Aimmecat/IEECS-Design/README.md

# IEECS-Design

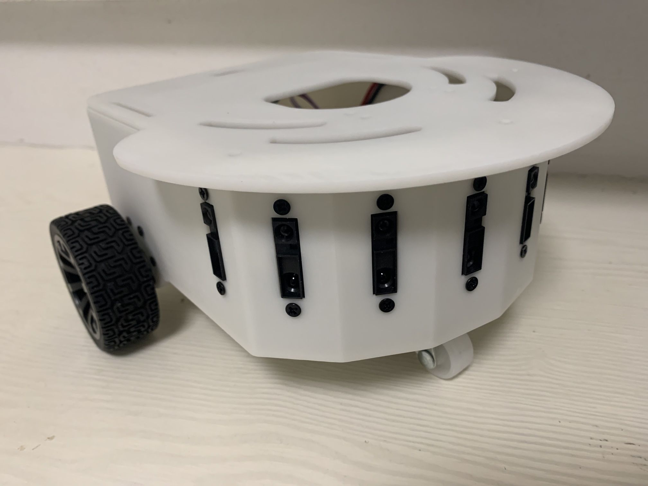
[picture p1: car.png]
car
This project is designed for the course: Introduction to EECS, which is MIT 6.01.
