Aimmecat/IEECS-Design/Hardware/Reference/CH32V307主板资料/ch32v307vct6_mother_board_example(1.3.1)/例程功能说明.xlsx

文件夹名称 | 中文翻译 | 说明
1-Button and Switch Demo | 按键
2-ServoMotor Control Demo | 舵机控制
3-Buzzer Demo | 蜂鸣器
4-MotorControl HIP4082 Demo | HIP4082驱动 | HIP4082为两个PWM信号控制一个电机
5-MotorControl DRV8701E Demo | DRV8701E | DRV8701E为一个PWM信号和一个DIR信号控制一个电机
6-4 Channels Encoder Dir Demo | 四通道带方向编码器采集 | 带方向的编码器采集历程
7-4 Channels Encoder Quad Demo | 四通道正交编码器采集 | 正交解码编码器采集历程
8-Wireless to UART Module Demo | 无线串口模块 | 无线串口模块发送和接收历程
9-ICM20602 6-Axis Module Demo | ICM20602模块 | 6轴数据采集历程
10-MPU6050 6-Axis Module Demo | MPU6050模块 | 6轴数据采集历程
11-OLED Display Demo | OLED显示
12-TFT 1.8 Display Demo | 1.8寸TFT显示
13-IPS 114 Display Demo | 1.14寸IPS屏幕显示
14-IPS 200 Display Demo | 2.0寸IPS屏幕显示
15.1-MT9V03x TFT_1.8 Mono Demo | 总钻风显示图像到1.8寸TFT屏幕 | 摄像头采集数据发送到屏幕上面
15.2-MT9V03x IPS_114 Mono Demo | 总钻风显示图像到1.14寸IPS屏幕 | 摄像头采集数据发送到屏幕上面
15.3-MT9V03x IPS_200 Mono Demo | 总钻风显示图像到2.0寸IPS屏幕 | 摄像头采集数据发送到屏幕上面
15.4-MT9V03x PC Mono Demo | 总钻风通过串口显示图像到上位机 | 摄像头采集数据发送到上位机上面
15.5-MT9V03x USB_CDC Mono Demo | 总钻风通过USB_CDC显示图像到上位机 | 摄像头采集数据发送到上位机上面
16-4 Channels ADC Demo | 4通道ADC采集 | 电感采集历程
17-Split_Ultrasonic_Module_Demo | 有来有去分体式超声模模块 | 有来有去测距历程
18.1-SCC8660 TFT_1.8 Mono Demo | 凌瞳(彩色摄像头)显示图像到1.8寸TFT屏幕 | 摄像头采集数据发送到屏幕上面
18.2-SCC8660 IPS_114 Mono Demo | 凌瞳(彩色摄像头)显示图像到1.14寸IPS屏幕 | 摄像头采集数据发送到屏幕上面
18.3-SCC8660 IPS_200 Mono Demo | 凌瞳(彩色摄像头)显示图像到2.0寸IPS屏幕 | 摄像头采集数据发送到屏幕上面
18.4-SCC8660 PC Mono Demo | 凌瞳(彩色摄像头)通过串口显示图像到上位机 | 摄像头采集数据发送到上位机上面
18.5-SCC8660 USB_CDC Mono Demo | 凌瞳(彩色摄像头)通过USB_CDC显示图像到上位机 | 摄像头采集数据发送到上位机上面
19-Bluetooth to UART Module Demo | 蓝牙转串口模块 | 蓝牙模块发送和接收历程
20-Wireless to 573 Module Demo | CH573模块 | CH573模块发送和接收历程
