Aimmecat/IEECS-Design/Hardware/Reference/CHV307_Library-master/Example/例程功能说明.xlsx

文件夹名称 | 中文翻译 | 说明
1-ADC Demo | ADC例程 | 本例程主要作用是，展示如何使用ADC模块
2-LED Blink Demo | LED闪烁例程 | 本例程主要作用是，展示如何使用普通GPIO模块
3-PIT Demo | PIT例程 | 本例程主要作用是，展示如何使用周期定时器中断
4-Encoder Demo | 编码器例程 | 本例程主要作用是，展示如何使用QTIMER模块来实现正交解码
5-UART Demo | 串口例程 | 本例程主要作用是，展示如何使用串口的发送与中断接收
6-Printf Demo | Printf例程 | 本例程主要作用是，展示如何使用Printf函数打印信息
7-GPIO Interrupt Demo | GPIO输入例程 | 本例程主要作用是，展示如何使用GPIO输入
8-Flash Demo | Flash例程 | 本例程主要作用是，展示如何使用片内flash保存参数
9-PWM Demo | PWM例程 | 本例程主要作用是，展示如何使用PWM模块输出PWM以及设定占空比
