Aimmecat/IEECS-Design/Course/6-01sc-spring-2011/6-01sc-spring-2011/contents/this-course-at-mit/formative-assessment-during-design-labs/electronic-help-queue/index.htm

MIT OpenCourseWare, Massachusetts Institute of Technology (https://ocw.mit.edu/)

An icon depicting an envelope. Subscribe to the OCW Newsletter (https://ocw.mit.edu/subscribe/index.htm?utm_source=header) | Click to visit our Google+ page. (https://plus.google.com/104567381989352550847/posts) Click to visit our Pinterest page. (https://www.pinterest.com/mitocw/pins/) Click to visit our Facebook page. (https://facebook.com/mitocw) Click to visit our Twitter feed. (https://twitter.com/mitocw)

| | Advanced Search

# Electronic Help Queue

OCW Scholar

## Electronic Help Queue

In the design lab, students are always thinking, working, and being active—and the teaching staff is available to help them at all times. Students ask for help by putting themselves in our electronic help queue. The help queue is visible on screens to everyone, and any of the teaching staff can use their smartphones to “claim” students in the queue. We go to where students are working in the room (which is quite large—about 20 meters wide by 10 meters deep, with about 20 octagonal tables) and respond to their questions, help them, or teach them what they need to know in order to answer their own questions. Many times we engage them in a dialogue about their work. We also check to see if something went wrong earlier in their lab work in order to make sure they aren’t headed down the wrong path or have misconceptions that need to be addressed.

Table with five columns and three rows. Column 1 contains students' names and pictures; column 2 has the assignment names; column 3 has students’ table numbers; column 4 has staff names. Image of a student’s circuit test results, with the words: “You submitted the following circuit.” In the lower right corner is a grey box with the following text: “You are in position 1 in the help 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 Screenshot a white webpage with the following text: “WHDW: Section 1 DL08. Accurate as of Friday October 30, 2015; 04:39:44 PM. 83 students took nano quiz 08 in section 1. Number Completed Checkoffs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

Our Corporate Supporters

#### About MIT OpenCourseWare

MIT OpenCourseWare makes the materials used in the teaching of almost all of MIT's subjects available on the Web, free of charge. With more than 2,400 courses available, OCW is delivering on the promise of open sharing of knowledge. Learn more » (http://ocw.mit.edu/about/)

Massachusetts Institute of Technology logo and name. (http://web.mit.edu) MIT Office of Digital Learning logo and name. (http://odl.mit.edu) Open Education Consortium logo. (http://www.oeconsortium.org/) Creative Commons logo with terms BY-NC-SA. (http://creativecommons.org/licenses/by-nc-sa/4.0/)

© 2001–2017
Massachusetts Institute of Technology

Your use of the MIT OpenCourseWare site and materials is subject to our Creative Commons License (https://creativecommons.org/licenses/by-nc-sa/4.0/) and other terms of use.
