Aimmecat/IEECS-Design/Hardware/Reference/CH32V307主板资料/ch32v307vct6_mother_board_example(1.3.1)/version.xls

单片机型号 时间（版本号） | CH32V103R8T6
2021.12.04（1.0.0） | 初始版本
2021.12.08（1.1.0） | 修复 摄像头引脚D0-D7宏定义错误的问题。
2021.12.09（1.1.1） | 修改 摄像头部分注释
2021.12.11（1.1.2） | 修改 摄像头部分注释
2022.01.10（1.1.3） | 对换蓝牙模块CH1和CH2的引脚
2022.01.11（1.1.4） | 对调isr.c中的CH1和CH2的回调函数
2022.03.10（1.2.0） | 更新底层，增加CH573历程
2022.03.17（1.3.0） | 更新底层，修复屏幕显示BUG
2022.03.30（1.3.1） | 更新底层，修复ADC的BUG
