Aimmecat/IEECS-Design/Hardware/Reference/CH32V307主板资料/ch32v307vct6_mother_board_example(1.3.1)/本例程下的库与开源库不同之处.xlsx

文件名称 | 参数 | 开源库默认值 | 例程需要设置的值
没用不同
