Aimmecat/IEECS-Design/Course/6-01sc-spring-2011/6-01sc-spring-2011/contents/6-01scs11.jpg

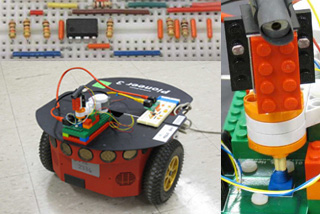
Course/6-01sc-spring-2011/6-01sc-spring-2011/contents/6-01scs11.jpg
