Aimmecat/IEECS-Design/Course/6-01sc-spring-2011/6-01sc-spring-2011/contents/this-course-at-mit/6-01SC_classroom-1.jpg

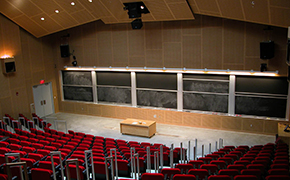
Course/6-01sc-spring-2011/6-01sc-spring-2011/contents/this-course-at-mit/6-01SC_classroom-1.jpg
