Aimmecat/IEECS-Design/Course/6-01sc-spring-2011/6-01sc-spring-2011/contents/this-course-at-mit/flipping-the-classroom-to-facilitate-active-learning/TLP_8706.JPG

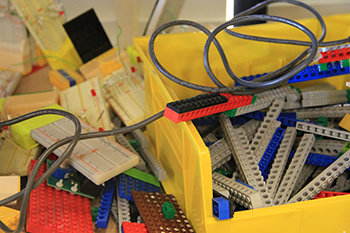
Course/6-01sc-spring-2011/6-01sc-spring-2011/contents/this-course-at-mit/flipping-the-classroom-to-facilitate-active-learning/TLP_8706.JPG
