Aimmecat/IEECS-Design/Course/6-01sc-spring-2011/6-01sc-spring-2011/contents/this-course-at-mit/formative-assessment-during-design-labs/electronic-help-queue/ig2_student-view.png

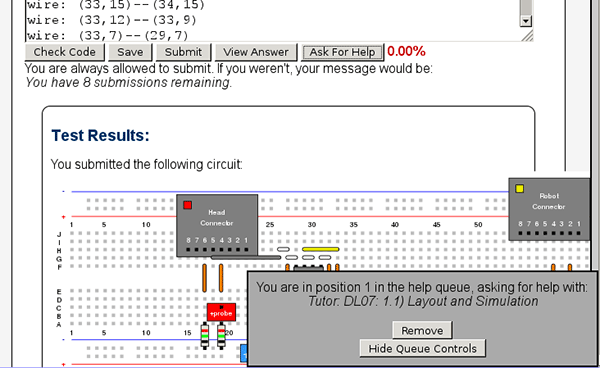
Course/6-01sc-spring-2011/6-01sc-spring-2011/contents/this-course-at-mit/formative-assessment-during-design-labs/electronic-help-queue/ig2_student-view.png
