Aimmecat/IEECS-Design/Course/6-01sc-spring-2011/6-01sc-spring-2011/contents/this-course-at-mit/shifting-to-a-practice-theory-practice-approach/TLP_8714.JPG

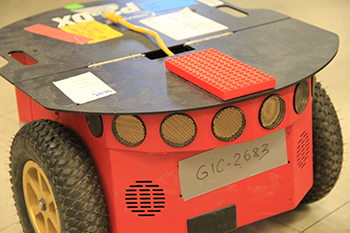
Course/6-01sc-spring-2011/6-01sc-spring-2011/contents/this-course-at-mit/shifting-to-a-practice-theory-practice-approach/TLP_8714.JPG
