Aimmecat/IEECS-Design/Course/6-01sc-spring-2011/6-01sc-spring-2011/contents/unit-2-signals-and-systems/unit2.jpg

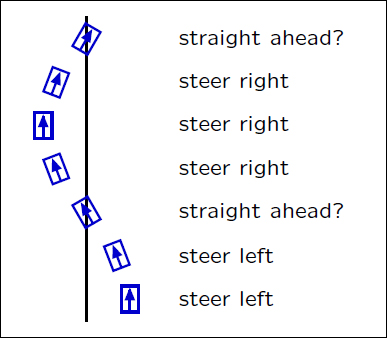
Course/6-01sc-spring-2011/6-01sc-spring-2011/contents/unit-2-signals-and-systems/unit2.jpg
