Aimmecat/IEECS-Design/Course/6-01sc-spring-2011/6-01sc-spring-2011/contents/unit-3-circuits/unit3.jpg

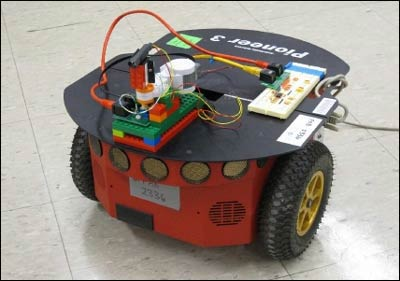
Course/6-01sc-spring-2011/6-01sc-spring-2011/contents/unit-3-circuits/unit3.jpg
