Aimmecat/IEECS-Design/Course/6-01sc-spring-2011/6-01sc-spring-2011/contents/unit-4-probability-and-planning/unit4.jpg

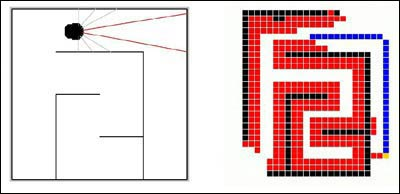
Course/6-01sc-spring-2011/6-01sc-spring-2011/contents/unit-4-probability-and-planning/unit4.jpg
