Aimmecat/IEECS-Design/Hardware/CarModel/3D-Head/支撑器.step

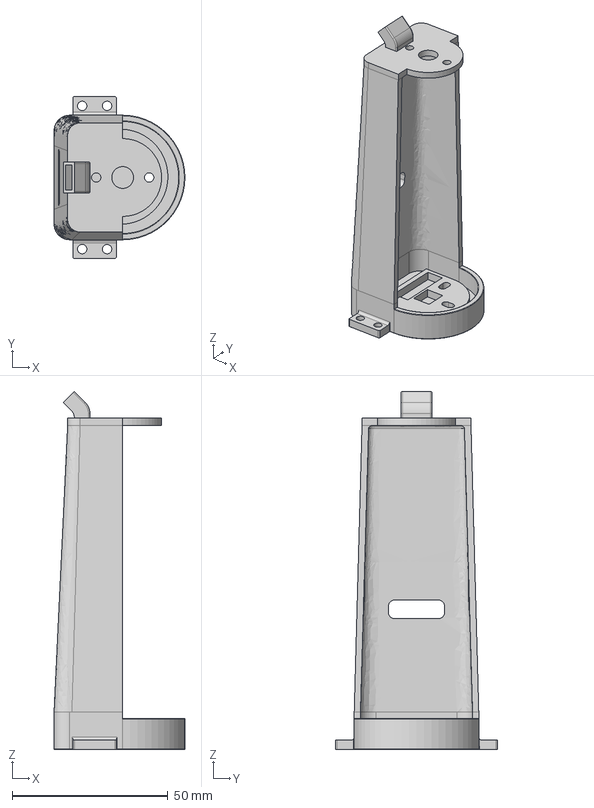
[picture p50: CAD file, 2022-12-30]
Hardware/CarModel/3D-Head/支撑器.step
42.0 x 52.0 x 115.0 mm
