Aimmecat/IEECS-Design/Hardware/CarModel/3D-parts/主干.stl

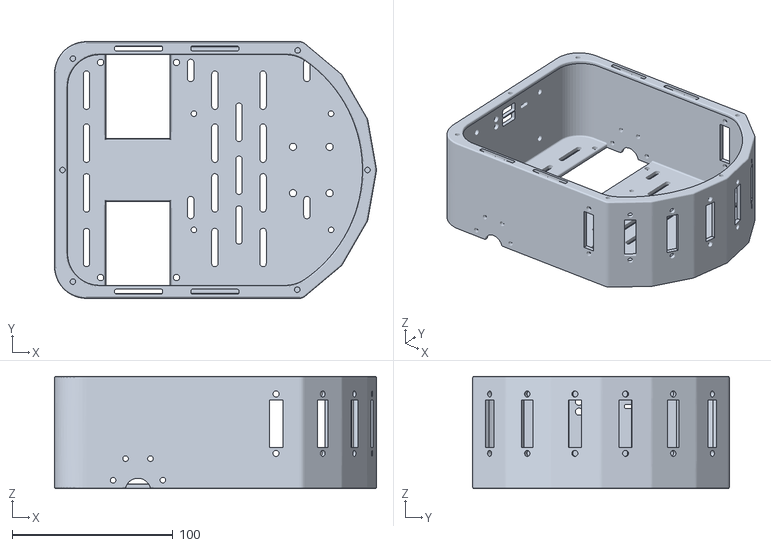
[picture p51: CAD file, 2022-12-30]
Hardware/CarModel/3D-parts/主干.stl
200.6 x 160.0 x 70.0
