Aimmecat/IEECS-Design/Hardware/CarModel/3D-Head/连接件.step

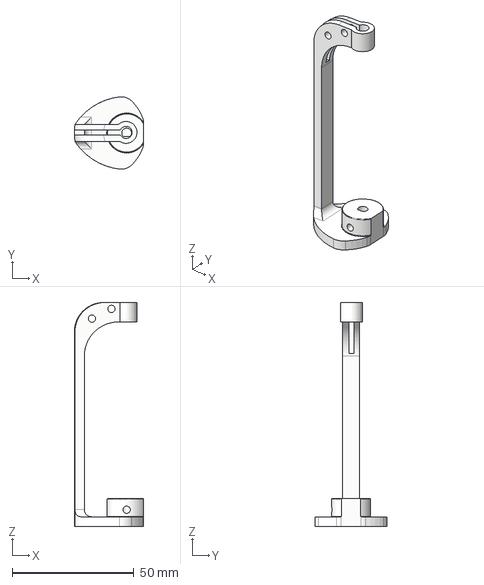
[picture p52: CAD file, 2022-12-30]
Hardware/CarModel/3D-Head/连接件.step
28.5 x 29.8 x 92.0 mm
