Aimmecat/IEECS-Design/Hardware/CarModel/3D-parts/电机托.step

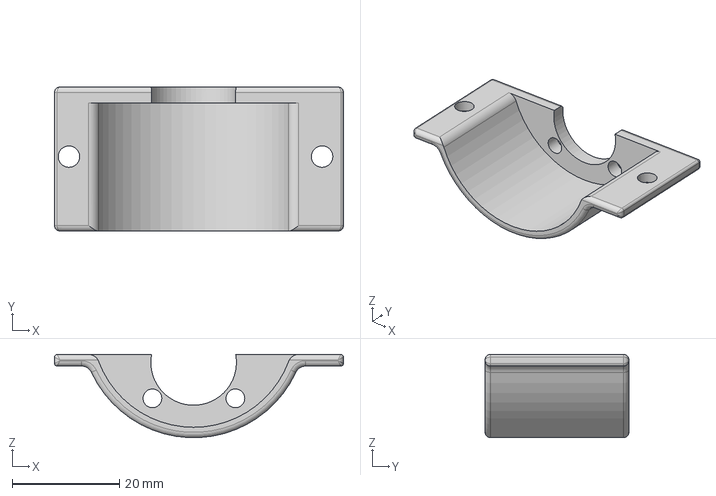
[picture p53: CAD file, 2022-12-30]
Hardware/CarModel/3D-parts/电机托.step
54.0 x 26.9 x 15.5 mm
