Aimmecat/IEECS-Design/Hardware/CarModel/3D-Head/光敏电阻安装器.step

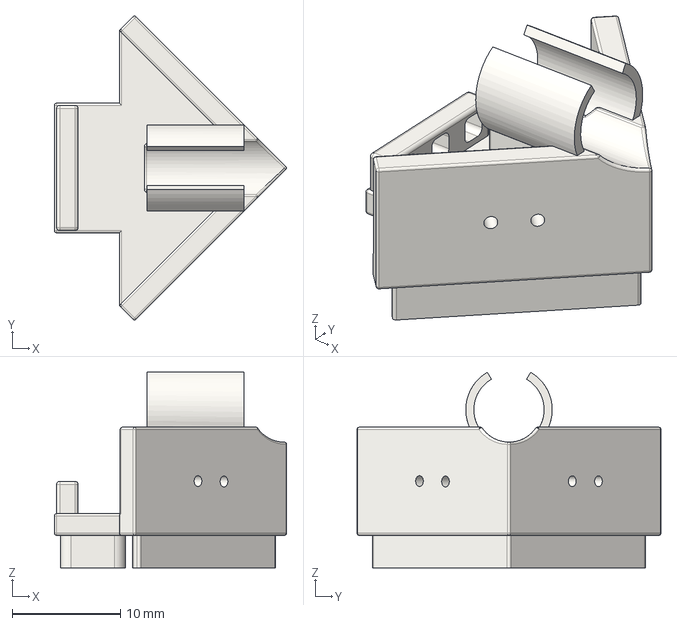
[picture p54: CAD file, 2022-12-30]
Hardware/CarModel/3D-Head/光敏电阻安装器.step
21.5 x 28.1 x 18.1 mm
