Aimmecat/IEECS-Design/Hardware/CarModel/3D-parts/盖子.step

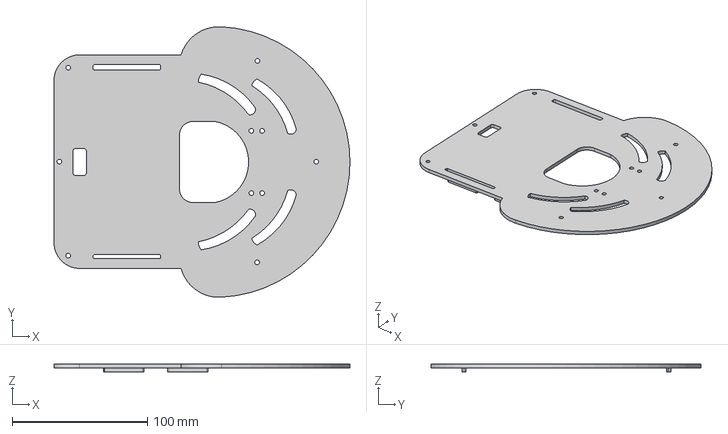
[picture p55: CAD file, 2022-12-30]
Hardware/CarModel/3D-parts/盖子.step
218.9 x 200.0 x 6.00 mm
