Aimmecat/IEECS-Design/(list of files, cad)

Other CAD files:
Hardware/CarModel/3D-parts/主体.step
Hardware/CarModel/3D-Head/光敏电阻安装器.stl
Hardware/CarModel/3D-Head/支撑器.stl
Hardware/CarModel/3D-Head/连接件.stl
Hardware/CarModel/3D-parts/电机托.stl
Hardware/CarModel/3D-parts/盖子.stl
