Aimmecat/IEECS-Design/Course/6-01sc-spring-2011/6-01sc-spring-2011/contents/python-tutorial/part-2/MIT6_01SCS11_py2_1_3.pdf

# Problem Wk.2.1.3: Scoping

Enter the value of the expressions below.

1. def foo (x):
def bar (x):
return x+1
return bar(x*2)
foo(3)
2. def foo (x):
def bar (z):
return z+x
return bar(3)
foo(2)

## MIT OpenCourseWare

http://ocw.mit.edu

## 6.01SC Introduction to Electrical Engineering and Computer Science

## Spring 2011

For information about citing these materials or our Terms of Use, visit: http://ocw.mit.edu/terms.
