Aimmecat/IEECS-Design/Course/6-01sc-spring-2011/6-01sc-spring-2011/contents/python-tutorial/part-2/MIT6_01SCS11_py2_2_1.pdf

## Problem Wk.2.2.1: Square

Define a procedure square(x) that takes a numeric parameter x and returns its square. It should have type num -> num.

MIT OpenCourseWare
http://ocw.mit.edu

### 6.01SC Introduction to Electrical Engineering and Computer Science

Spring 2011

For information about citing these materials or our Terms of Use, visit: http://ocw.mit.edu/terms.
