Aimmecat/IEECS-Design/Course/6-01sc-spring-2011/6-01sc-spring-2011/contents/python-tutorial/part-2/MIT6_01SCS11_py2_2_5.pdf

## Problem Wk.2.2.5: Evaluate a quadratic at a point

Define a procedure evalQuadratic(a, b, c, x) that returns the value of the quadratic a

x²

+ b x + c. Your function should have type (num, num, num, num) -> num.

MIT OpenCourseWare
http://ocw.mit.edu

### 6.01SC Introduction to Electrical Engineering and Computer Science

Spring 2011

For information about citing these materials or our Terms of Use, visit: http://ocw.mit.edu/terms.
