Aimmecat/IEECS-Design/Course/6-01sc-spring-2011/6-01sc-spring-2011/contents/python-tutorial/part-3/MIT6_01SCS11_py3_1_2.pdf

## Problem Wk.3.1.2: Compare

Define a procedure compare(x,y) that returns 1 if x is greater than y, 0 if x equals y and -1 if x is less than y. Use elif to write the comparison.

MIT OpenCourseWare
http://ocw.mit.edu

### 6.01SC Introduction to Electrical Engineering and Computer Science

Spring 2011

For information about citing these materials or our Terms of Use, visit: http://ocw.mit.edu/terms.
