Aimmecat/IEECS-Design/Course/6-01sc-spring-2011/6-01sc-spring-2011/contents/python-tutorial/part-3/MIT6_01SCS11_py3_2_4.pdf

## Problem Wk.3.2.4: Muad-Div

Define a procedure div(m, n), which returns the integer part of m / n, where both arguments are positive integers. Don't use /. Your function should have type
(positiveInt, positiveInt) -> positiveInt

MIT OpenCourseWare
http://ocw.mit.edu

### 6.01SC Introduction to Electrical Engineering and Computer Science

Spring 2011

For information about citing these materials or our Terms of Use, visit: http://ocw.mit.edu/terms.
