Aimmecat/IEECS-Design/Course/6-01sc-spring-2011/6-01sc-spring-2011/contents/python-tutorial/part-3/MIT6_01SCS11_py3_2_5.pdf

## Problem Wk.3.2.5: Primo

Define a procedure prime(n), which returns True if n is prime and False otherwise. It's okay if it's slow. Your function should have type (positiveInt) -> boolean

MIT OpenCourseWare
http://ocw.mit.edu

### 6.01SC Introduction to Electrical Engineering and Computer Science

Spring 2011

For information about citing these materials or our Terms of Use, visit: http://ocw.mit.edu/terms.
