Aimmecat/IEECS-Design/Course/6-01sc-spring-2011/6-01sc-spring-2011/contents/python-tutorial/part-3/MIT6_01SCS11_py3_2_6.pdf

## Problem Wk.3.2.6: Powers of 2

Define a procedure p2(x) that takes an integer parameter x. If x is greater than 1, the procedure returns the largest power of two that is less than x; otherwise, it returns 0. Use a loop.

MIT OpenCourseWare
http://ocw.mit.edu

### 6.01SC Introduction to Electrical Engineering and Computer Science

Spring 2011

For information about citing these materials or our Terms of Use, visit: http://ocw.mit.edu/terms.
