Aimmecat/IEECS-Design/Course/6-01sc-spring-2011/6-01sc-spring-2011/contents/python-tutorial/part-5/MIT6_01SCS11_py5_3_2.pdf

elements of the original list, starting with the first. So, you'd get

>>> everyOther([1, 2, 3, 4, 5])
[1, 3, 5]
>>> everyOther(['this', 'is', 'a', 'sentence'])
['this', 'a']
You can do this using the things you already know; or you can go read the Python Tutorial documentation (http://docs.python.org/tutorial/controlflow.html#the-range-function) about fancier uses of range.

## Problem Wk.5.3.2: Every other

Write a procedure that takes a list as input and returns a new list with alternating

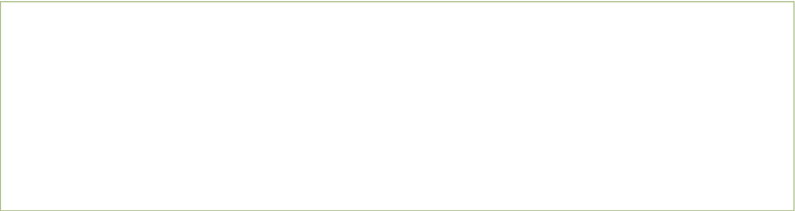
[picture p90: figure]

MIT OpenCourseWare
http://ocw.mit.edu

### 6.01SC Introduction to Electrical Engineering and Computer Science

Spring 2011

For information about citing these materials or our Terms of Use, visit: http://ocw.mit.edu/terms.
