Aimmecat/IEECS-Design/Course/6-01sc-spring-2011/6-01sc-spring-2011/contents/python-tutorial/part-5/MIT6_01SCS11_py5_3_3.pdf

## Problem Wk.5.3.3: Cat 6

In Python you can use + to concatenate two lists. Write a procedure, called cat6(l) that takes a list as an argument and returns a list with the integer 6 concatenated to the end; the output will be a list with one more element that the input.

MIT OpenCourseWare
http://ocw.mit.edu

### 6.01SC Introduction to Electrical Engineering and Computer Science

Spring 2011

For information about citing these materials or our Terms of Use, visit: http://ocw.mit.edu/terms.
