Aimmecat/IEECS-Design/Course/6-01sc-spring-2011/6-01sc-spring-2011/contents/python-tutorial/part-5/MIT6_01SCS11_py5_3_4.pdf

## Problem Wk.5.3.4: Home on the range

Write a procedure, called myRange, that takes a single positive integer n as an argument and returns a list with elements starting with 0 and going up through n - 1. Don't use
range! Use a while loop.

MIT OpenCourseWare
http://ocw.mit.edu

### 6.01SC Introduction to Electrical Engineering and Computer Science

Spring 2011

For information about citing these materials or our Terms of Use, visit: http://ocw.mit.edu/terms.
