Aimmecat/IEECS-Design/Course/6-01sc-spring-2011/6-01sc-spring-2011/contents/python-tutorial/part-5/MIT6_01SCS11_py5_3_8.pdf

## Problem Wk.5.3.8: Slice of Pi

Define a procedure piSeries(n), which computes a series approximation to pi with n

terms, using the formula:
Your function should have type positiveInt -> float. Be careful about integer division. Use a list comprehension.

MIT OpenCourseWare
http://ocw.mit.edu

### 6.01SC Introduction to Electrical Engineering and Computer Science

Spring 2011

For information about citing these materials or our Terms of Use, visit: http://ocw.mit.edu/terms.
