Aimmecat/IEECS-Design/Course/6-01sc-spring-2011/6-01sc-spring-2011/contents/python-tutorial/part-5/MIT6_01SCS11_py5_3_9.pdf

## Problem Wk.5.3.9: Polly

Define a procedure evalPolynomial(coeffs, x), which returns the value of

where coeffs is a list of coefficients, from highest to lowest order: | . A
straightforward way to evaluate polynomials is to explicitly add up the terms | . Do
this with list comprehension and sum.
Hint: note that in a polynomial with coefficients, the highest power of the variable is .
The type of this function should be (list(num), num) -> num.

MIT OpenCourseWare
http://ocw.mit.edu

### 6.01SC Introduction to Electrical Engineering and Computer Science

Spring 2011

For information about citing these materials or our Terms of Use, visit: http://ocw.mit.edu/terms.
