Aimmecat/IEECS-Design/Course/6-01sc-spring-2011/6-01sc-spring-2011/contents/python-tutorial/part-3/MIT6_01SCS11_py3_1_1.pdf

## Problem Wk.3.1.1: If statements

Below is a transcript of a session with the Python shell. Provide the type and value of the expressions being evaluated. If evaluating an expression would cause an error, select noneType and write error in the box. If the result is a function, select function and write function in the box. Assume the following definitions have been made:

def a(x, y, z):
if x:
return y
else:
return z
def b(y,z):
return a(y>z, y, z)
1. >>> a(False, 2, 3)
noneType
int
float
boolean
function
2. >>> b(3,2)
3. >>> a(3>2, a, b)
4. >>> b(a,b)
(Contrary to expectation, in Python, it is technically legal to compare functions. We actually were expecting this to generate an error, but it doesn't.)

This problem contains one or more multiple-choice questions. When a given set of choices is used for the first time, all choices are displayed. If there are several related questions, you can assume that the same choices are available for all questions.

MIT OpenCourseWare
http://ocw.mit.edu

### 6.01SC Introduction to Electrical Engineering and Computer Science

Spring 2011

For information about citing these materials or our Terms of Use, visit: http://ocw.mit.edu/terms.
