Aimmecat/IEECS-Design/Guide/figure/5V转3.3V.png

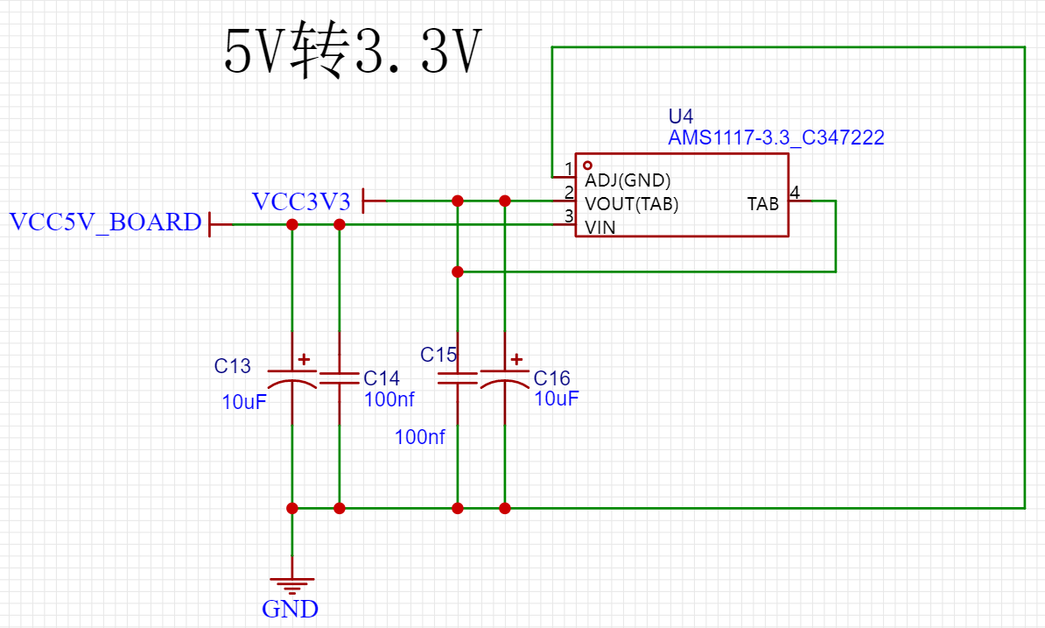
Guide/figure/5V转3.3V.png
