Aimmecat/IEECS-Design/Guide/figure/7.4V转5V.png

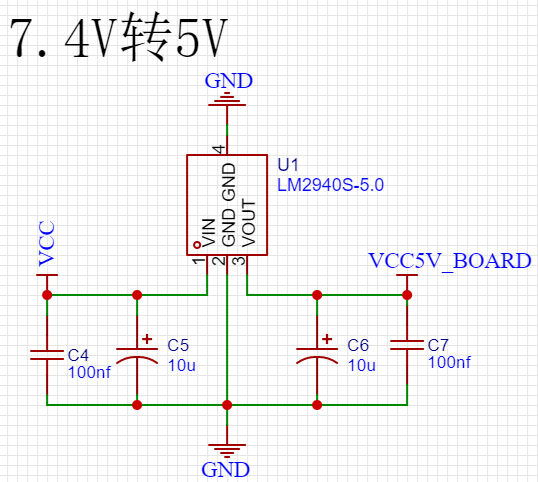
Guide/figure/7.4V转5V.png
