Aimmecat/IEECS-Design/Guide/figure/ADC分压电路.png

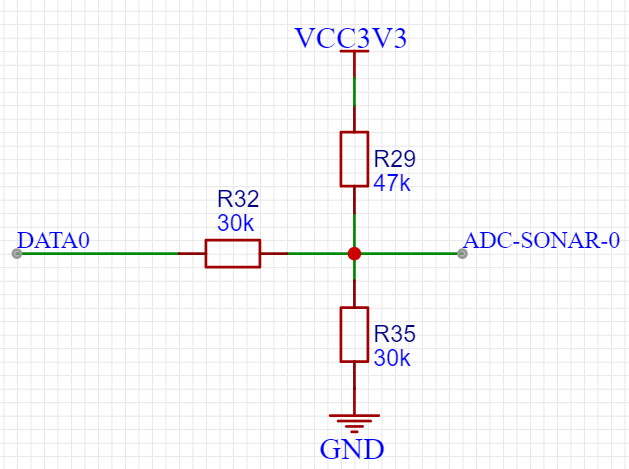
Guide/figure/ADC分压电路.png
