Aimmecat/IEECS-Design/Guide/figure/LidatFit.png

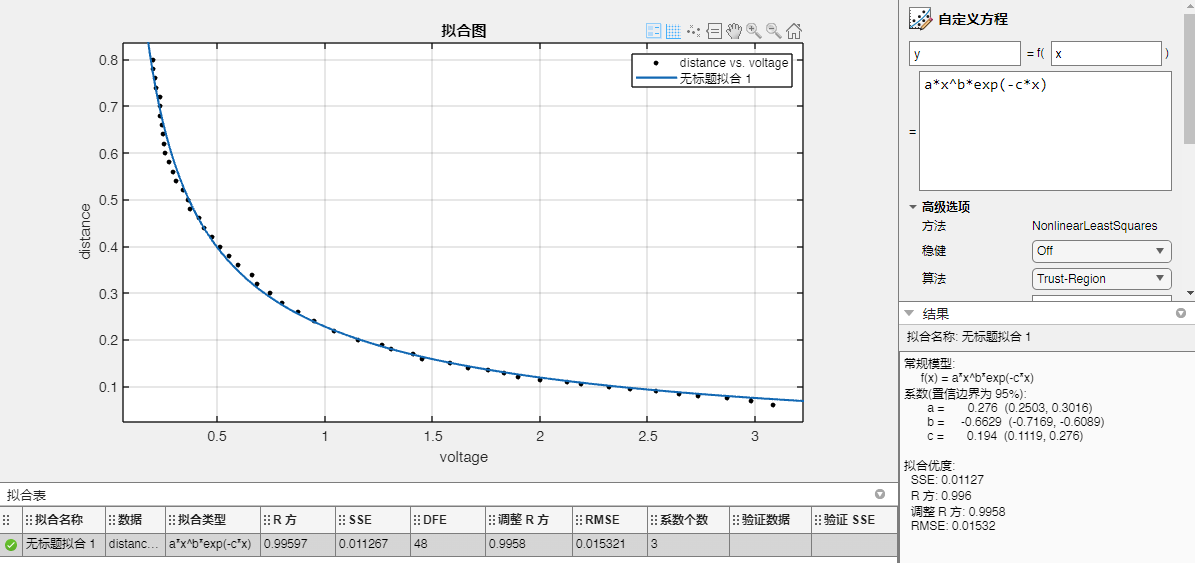
Guide/figure/LidatFit.png
