Aimmecat/IEECS-Design/Guide/figure/sendPacket.png

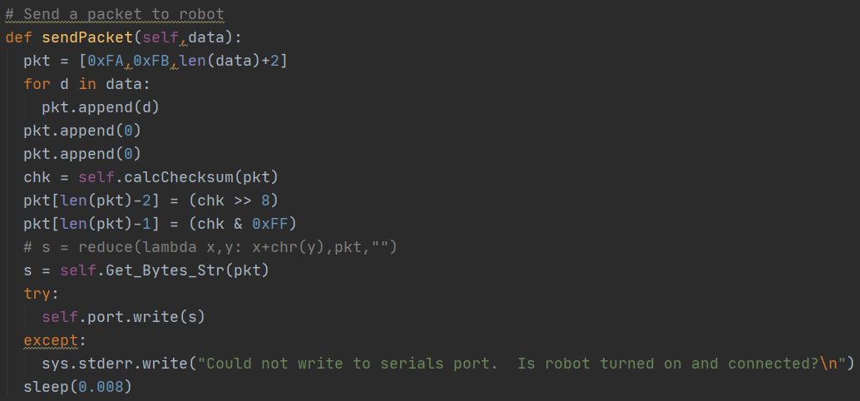
Guide/figure/sendPacket.png
