Aimmecat/IEECS-Design/Guide/figure/SensorInput.png

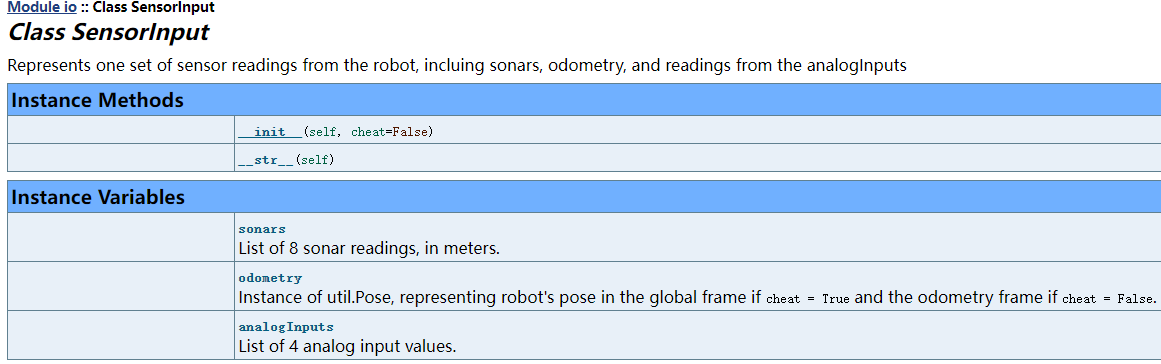
Guide/figure/SensorInput.png
