Aimmecat/IEECS-Design/Guide/figure/sipReceive.png

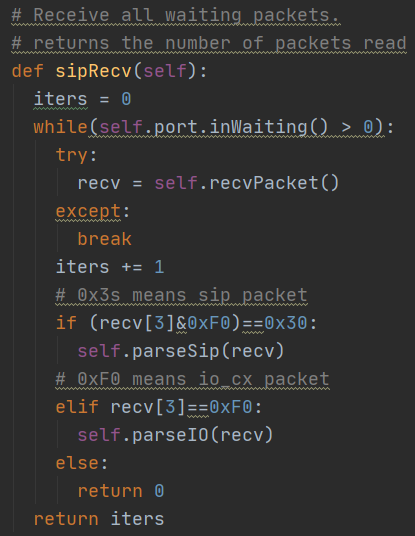
Guide/figure/sipReceive.png
