Aimmecat/IEECS-Design/Guide/figure/SM代码.png

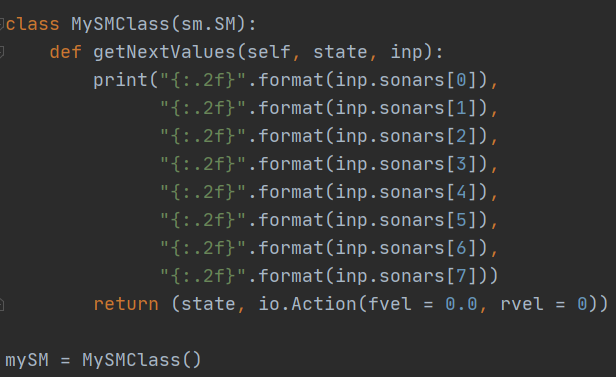
Guide/figure/SM代码.png
