Aimmecat/IEECS-Design/Guide/figure/Step函数.png

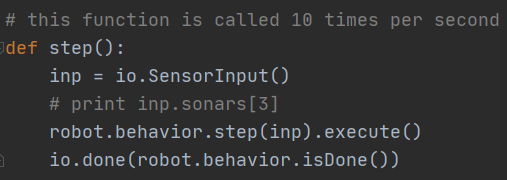
Guide/figure/Step函数.png
