Aimmecat/IEECS-Design/Guide/figure/主板3D图.png

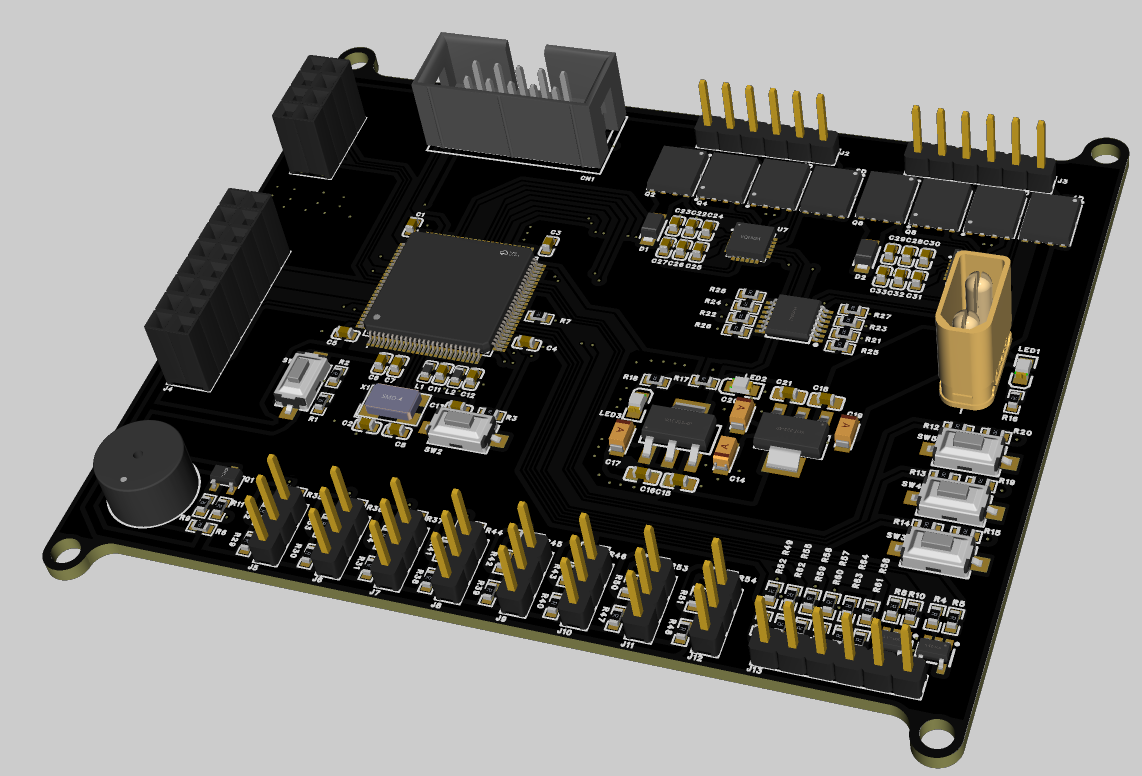
Guide/figure/主板3D图.png
