Aimmecat/IEECS-Design/Guide/figure/保持通讯.png

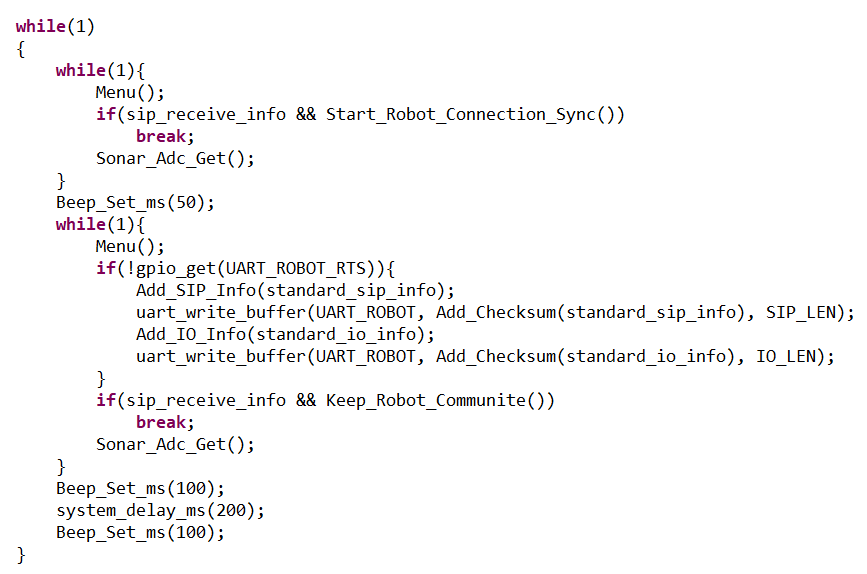
Guide/figure/保持通讯.png
