Aimmecat/IEECS-Design/Guide/figure/光敏电阻与激光灯安装.png

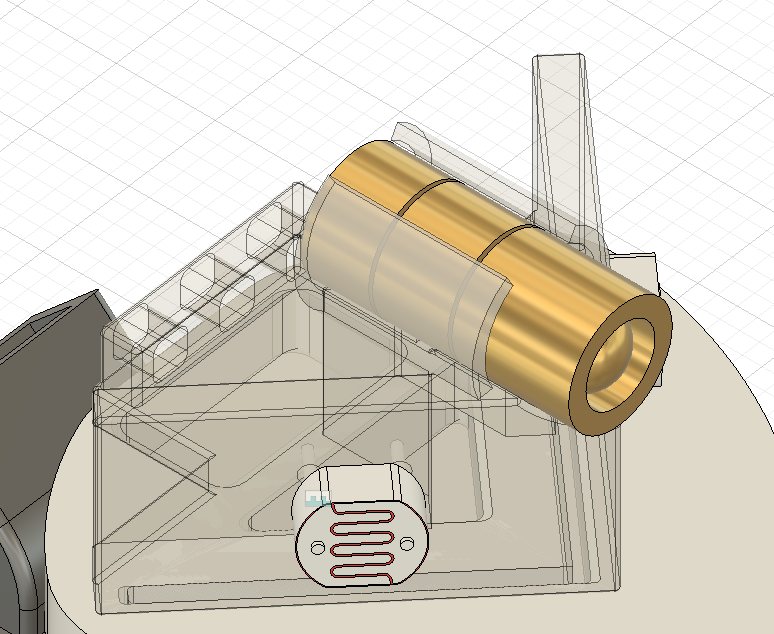
Guide/figure/光敏电阻与激光灯安装.png
