Aimmecat/IEECS-Design/Guide/figure/分压电路2.png

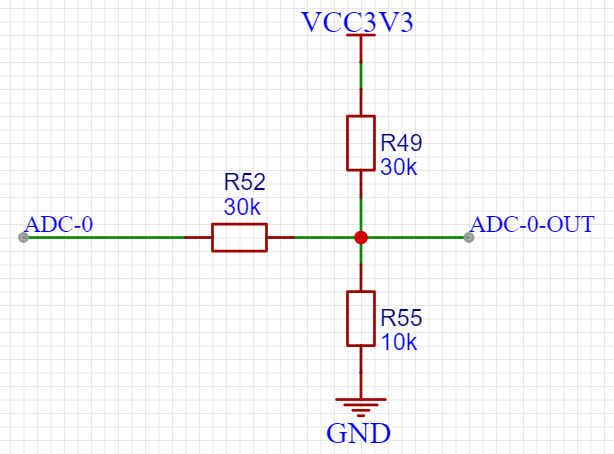
Guide/figure/分压电路2.png
