Aimmecat/IEECS-Design/Guide/figure/单次变换.png

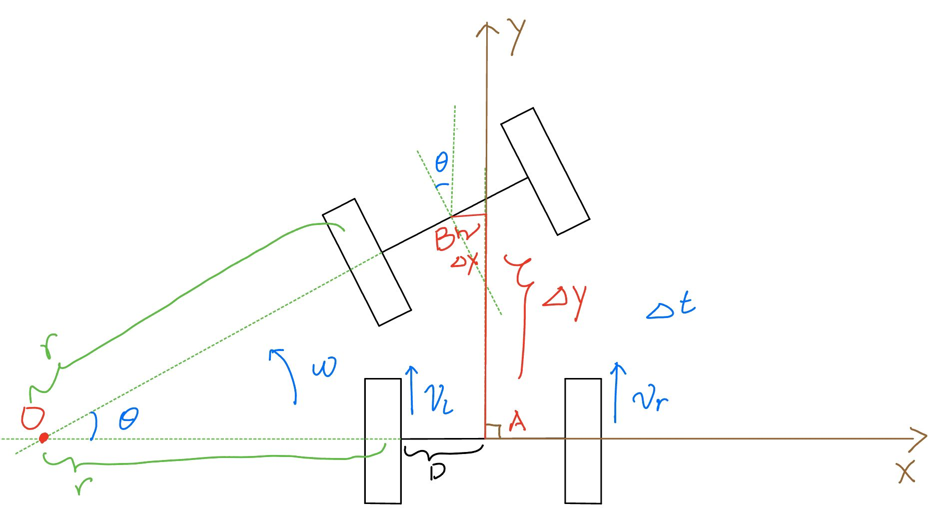
Guide/figure/单次变换.png
