Aimmecat/IEECS-Design/Guide/figure/坐标系转换.png

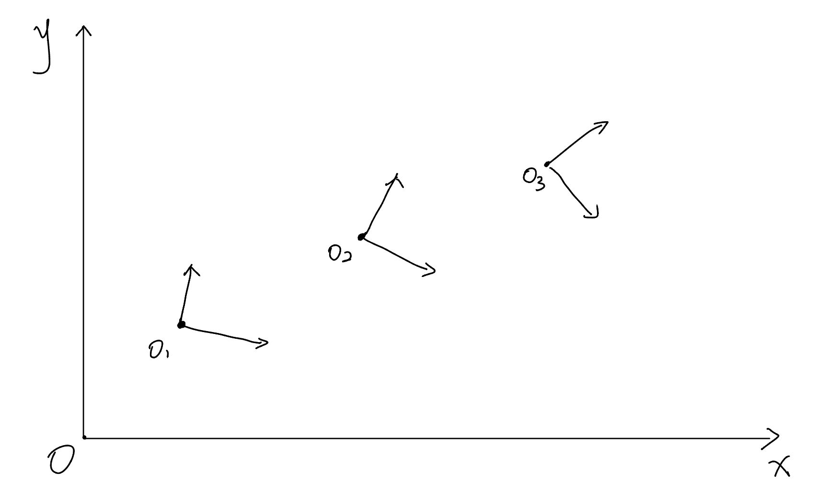
Guide/figure/坐标系转换.png
