Aimmecat/IEECS-Design/Guide/figure/按键电路.png

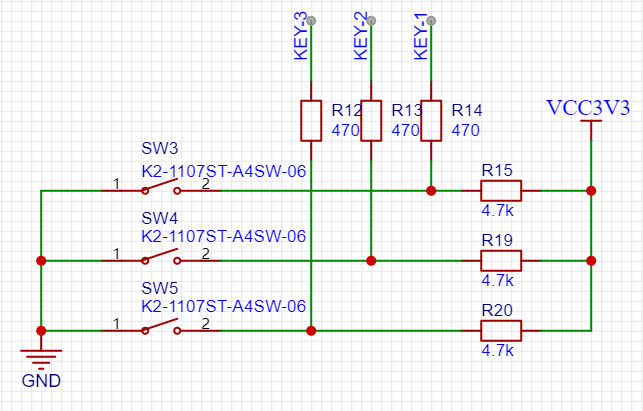
Guide/figure/按键电路.png
