Aimmecat/IEECS-Design/Guide/figure/电机驱动电路.png

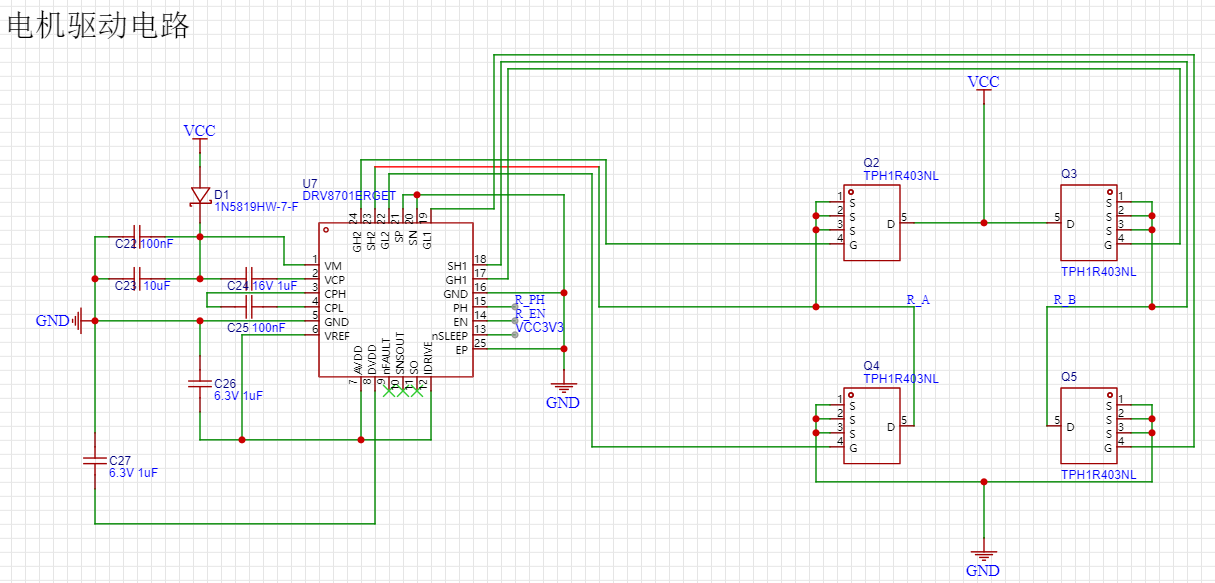
Guide/figure/电机驱动电路.png
