Aimmecat/IEECS-Design/Guide/figure/电源板3D图(反).png

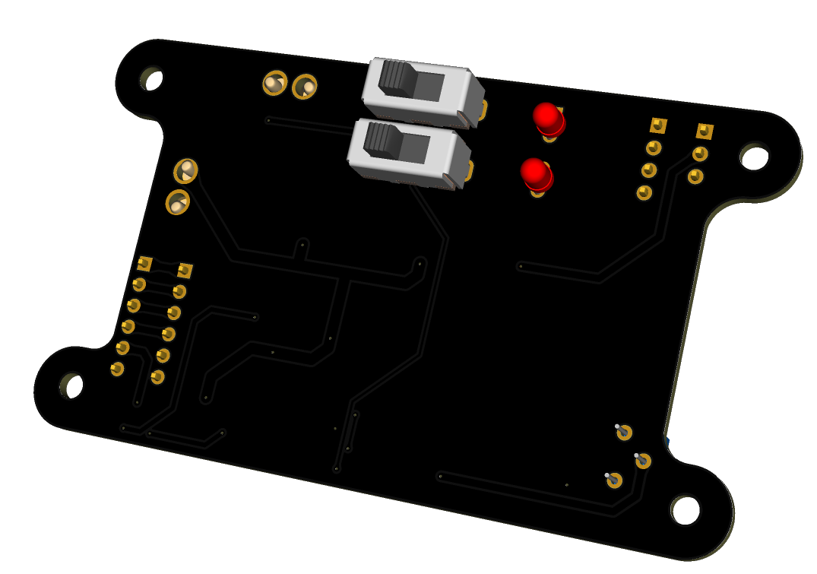
Guide/figure/电源板3D图(反).png
