Aimmecat/IEECS-Design/Guide/figure/电源板3D图(正).png

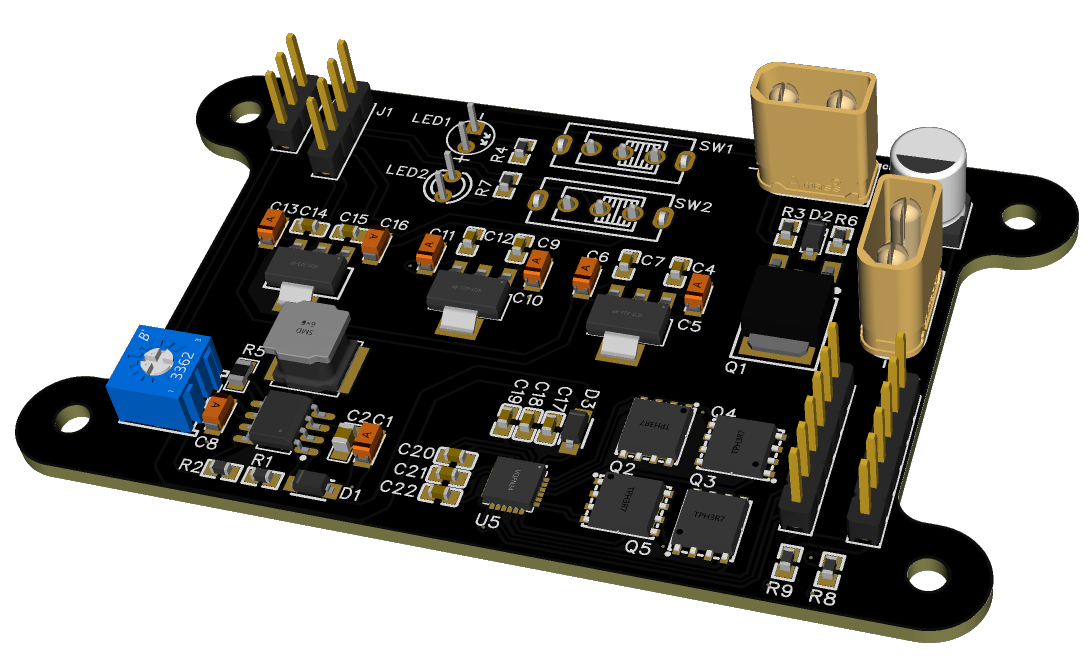
Guide/figure/电源板3D图(正).png
