Aimmecat/IEECS-Design/Guide/figure/电源输入.png

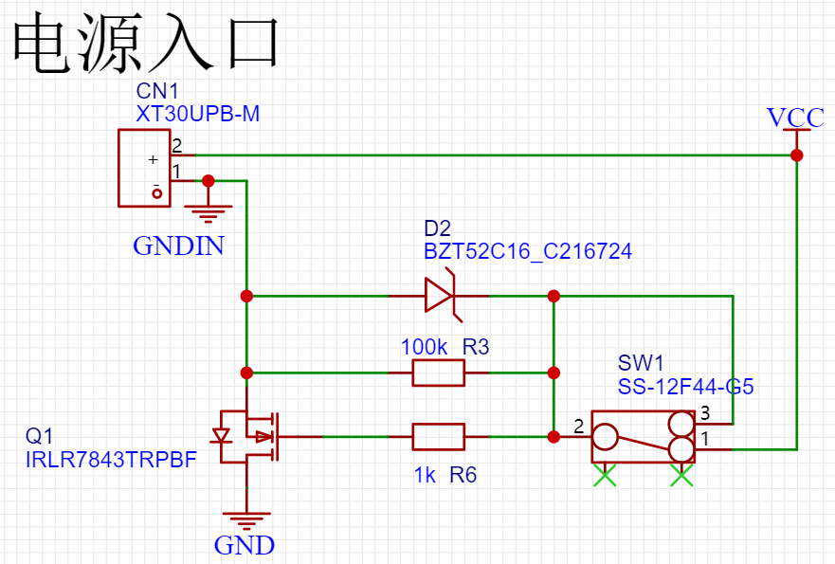
Guide/figure/电源输入.png
