Aimmecat/IEECS-Design/Guide/figure/蜂鸣器电路.png

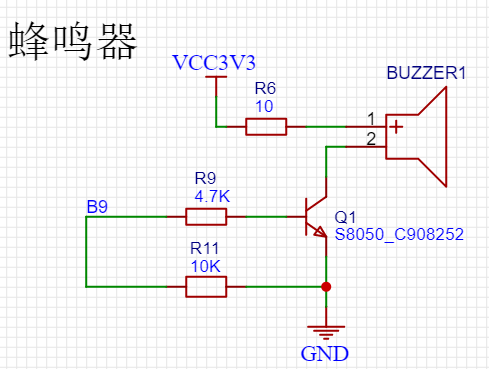
Guide/figure/蜂鸣器电路.png
