Aimmecat/IEECS-Design/Guide/figure/车模3D.png

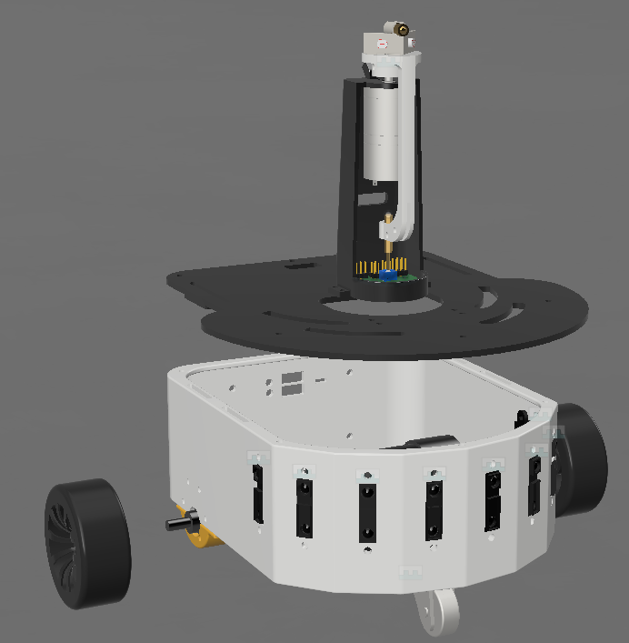
Guide/figure/车模3D.png
