Aimmecat/IEECS-Design/Guide/figure/隔离芯片.png

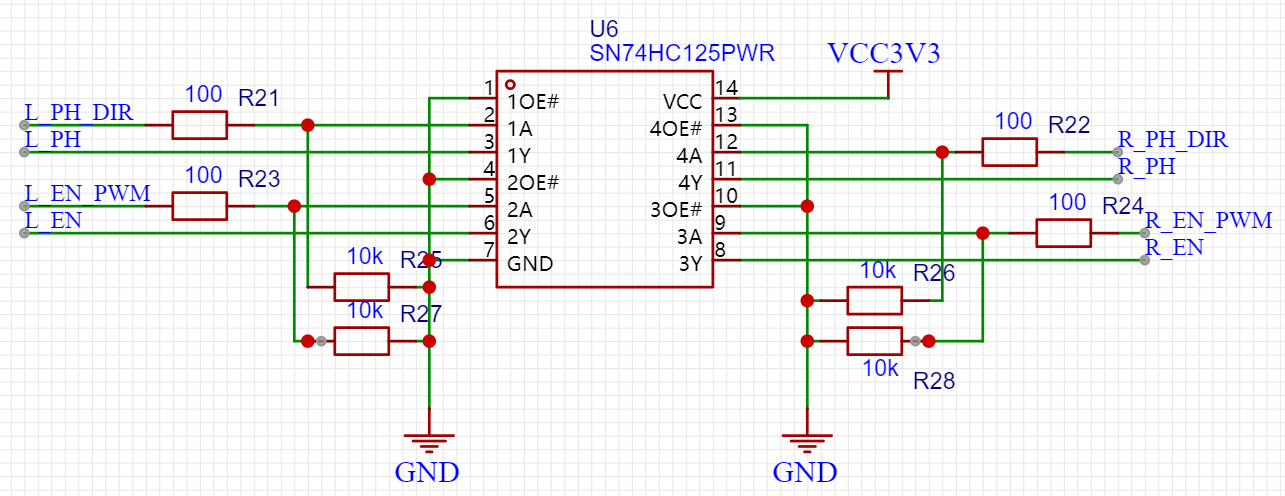
Guide/figure/隔离芯片.png
