Aimmecat/IEECS-Design/Hardware/Circuit/Schematic/Bat.pdf

7.4V->5V | 7.4V->10V

# 电源入口

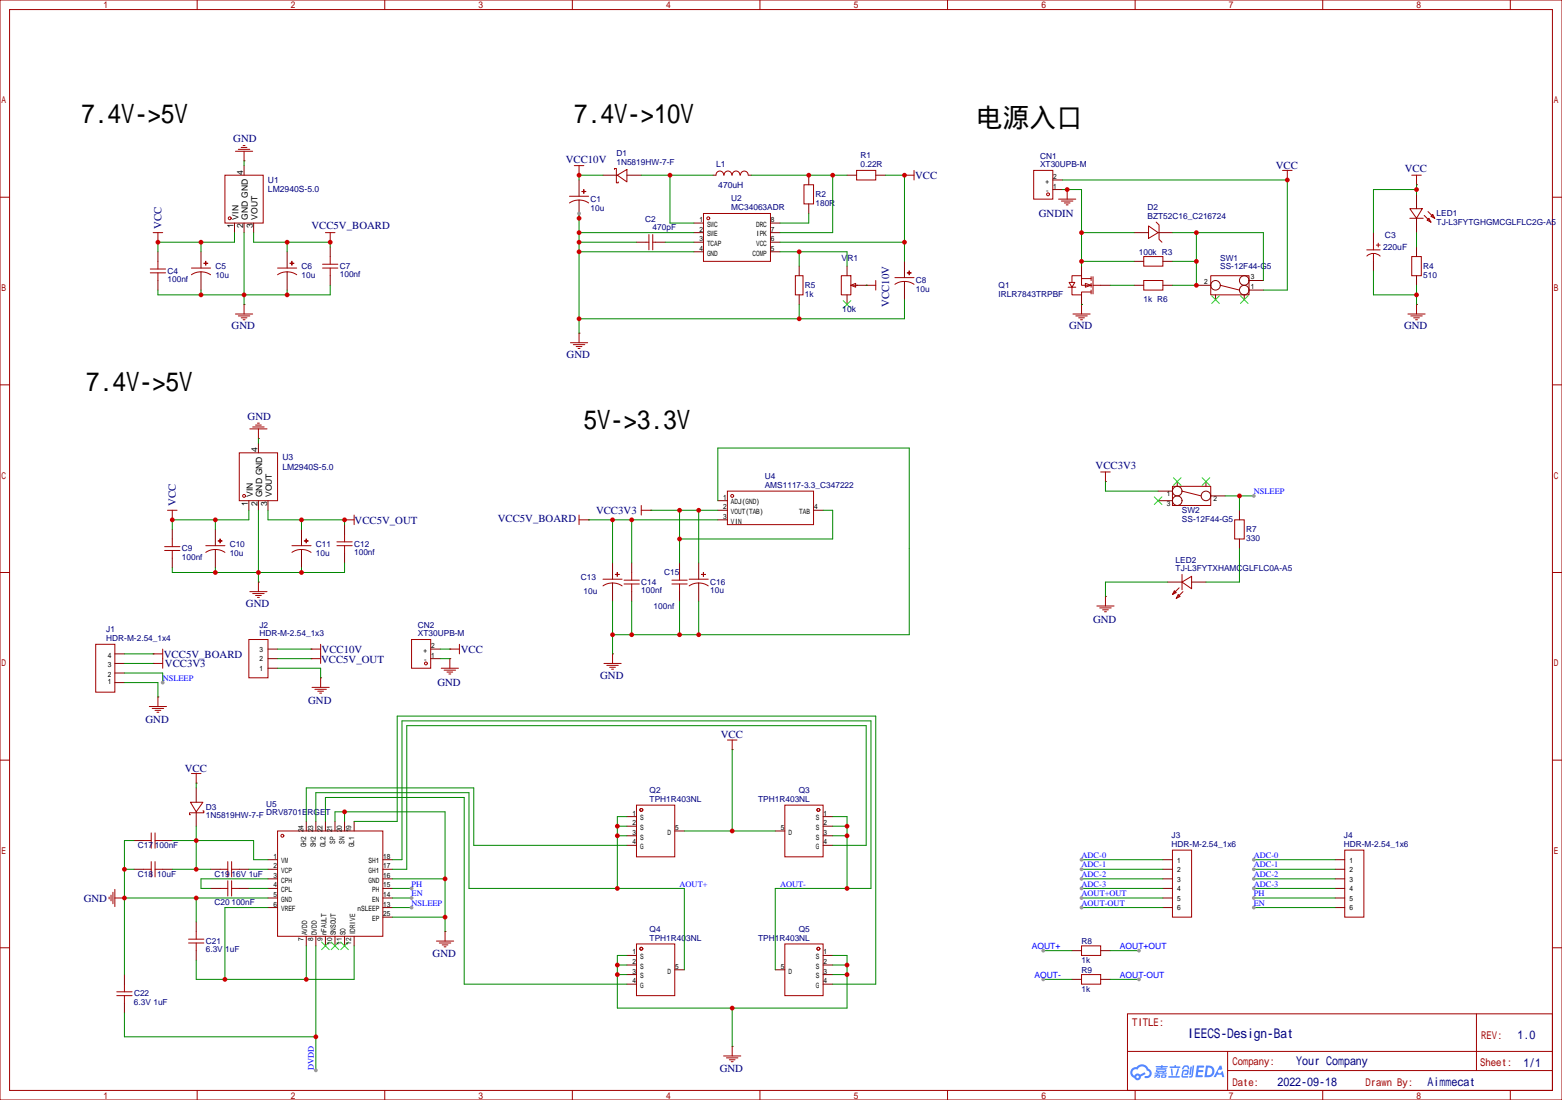
[picture p117: page 1]
