Aimmecat/IEECS-Design/Hardware/Circuit/Schematic/Mainboard.pdf

# 下载口

无线串口 | 电机/编码器接口 主控芯片

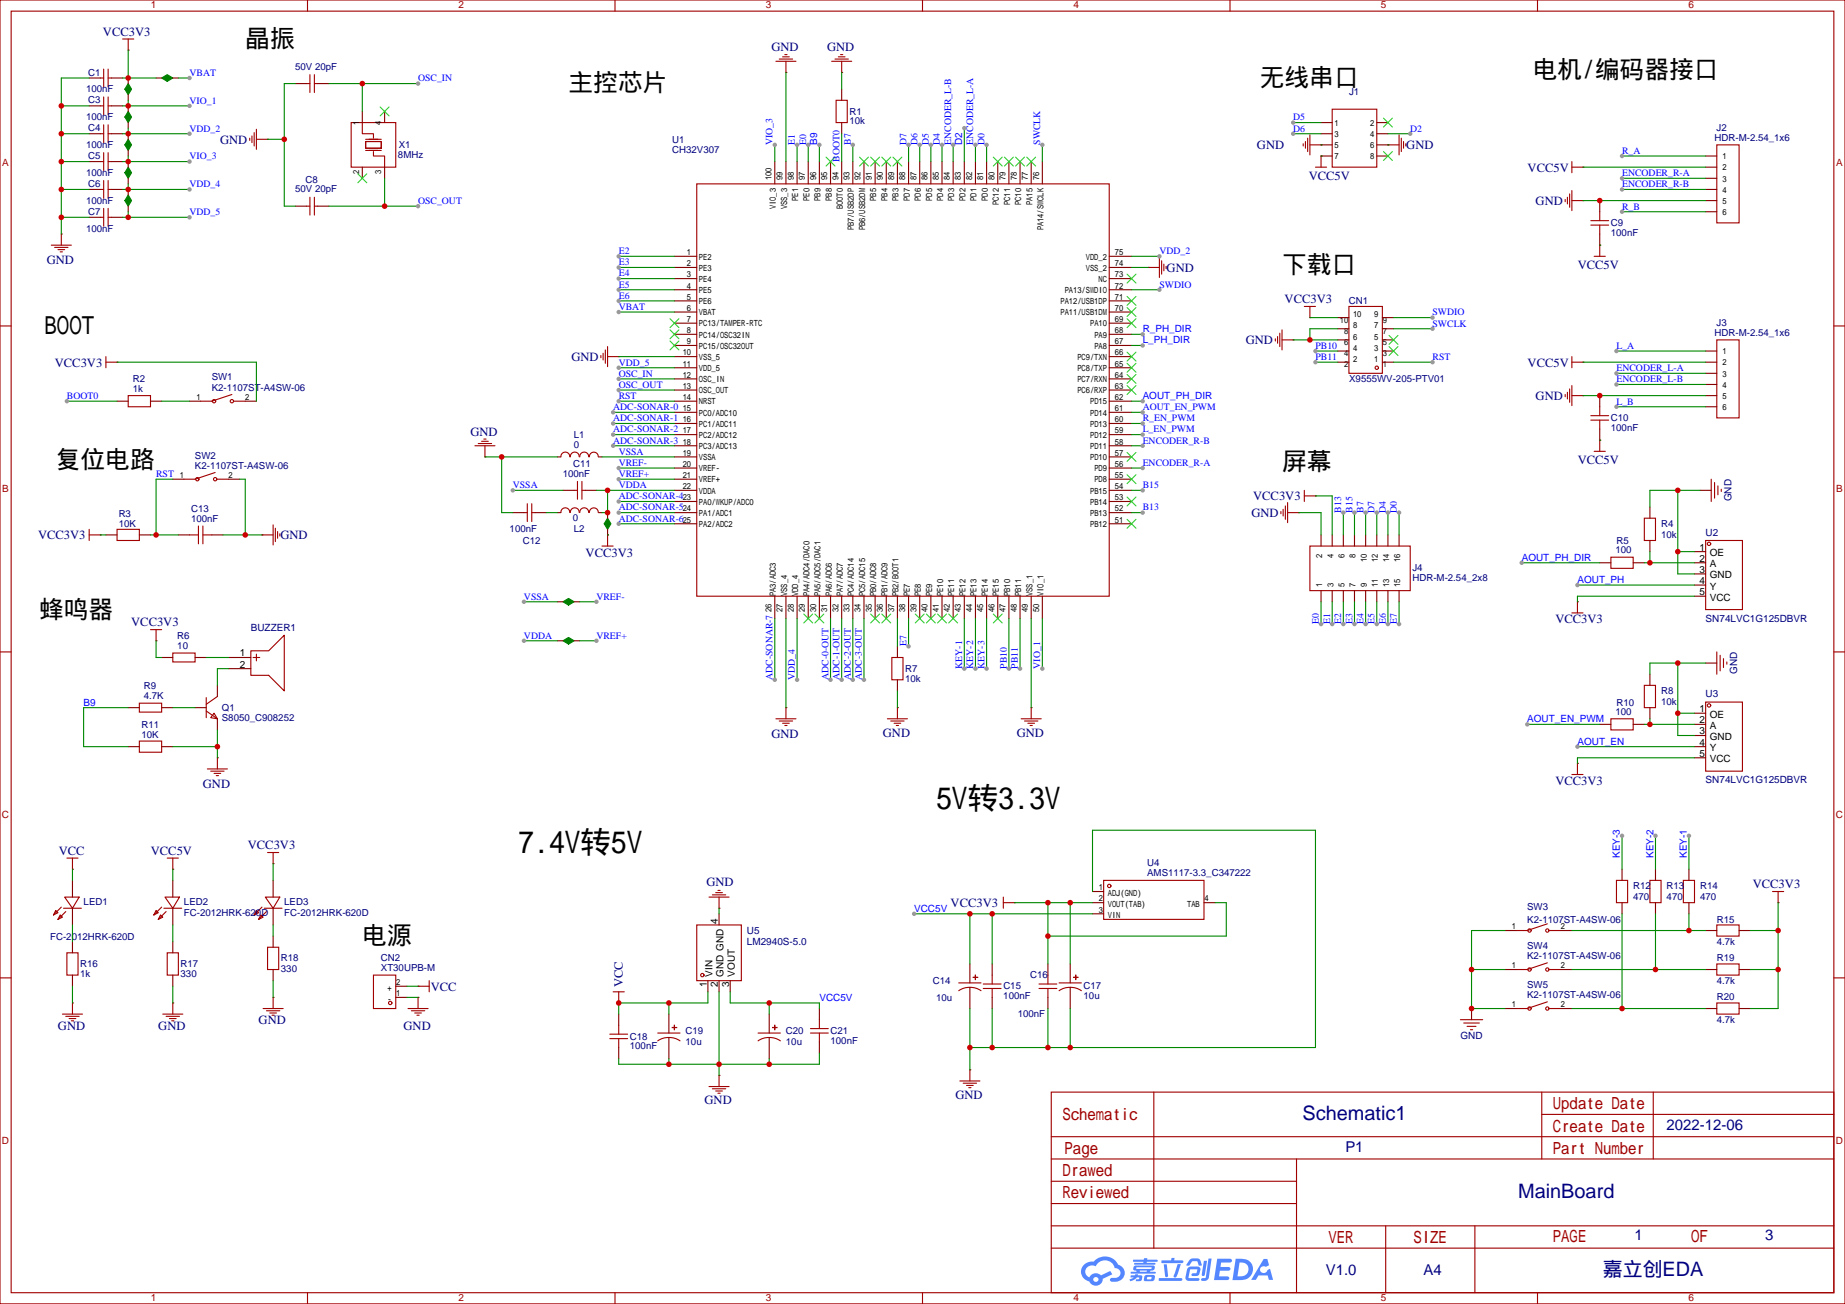
[picture p118: page 1]

# 电机驱动电路

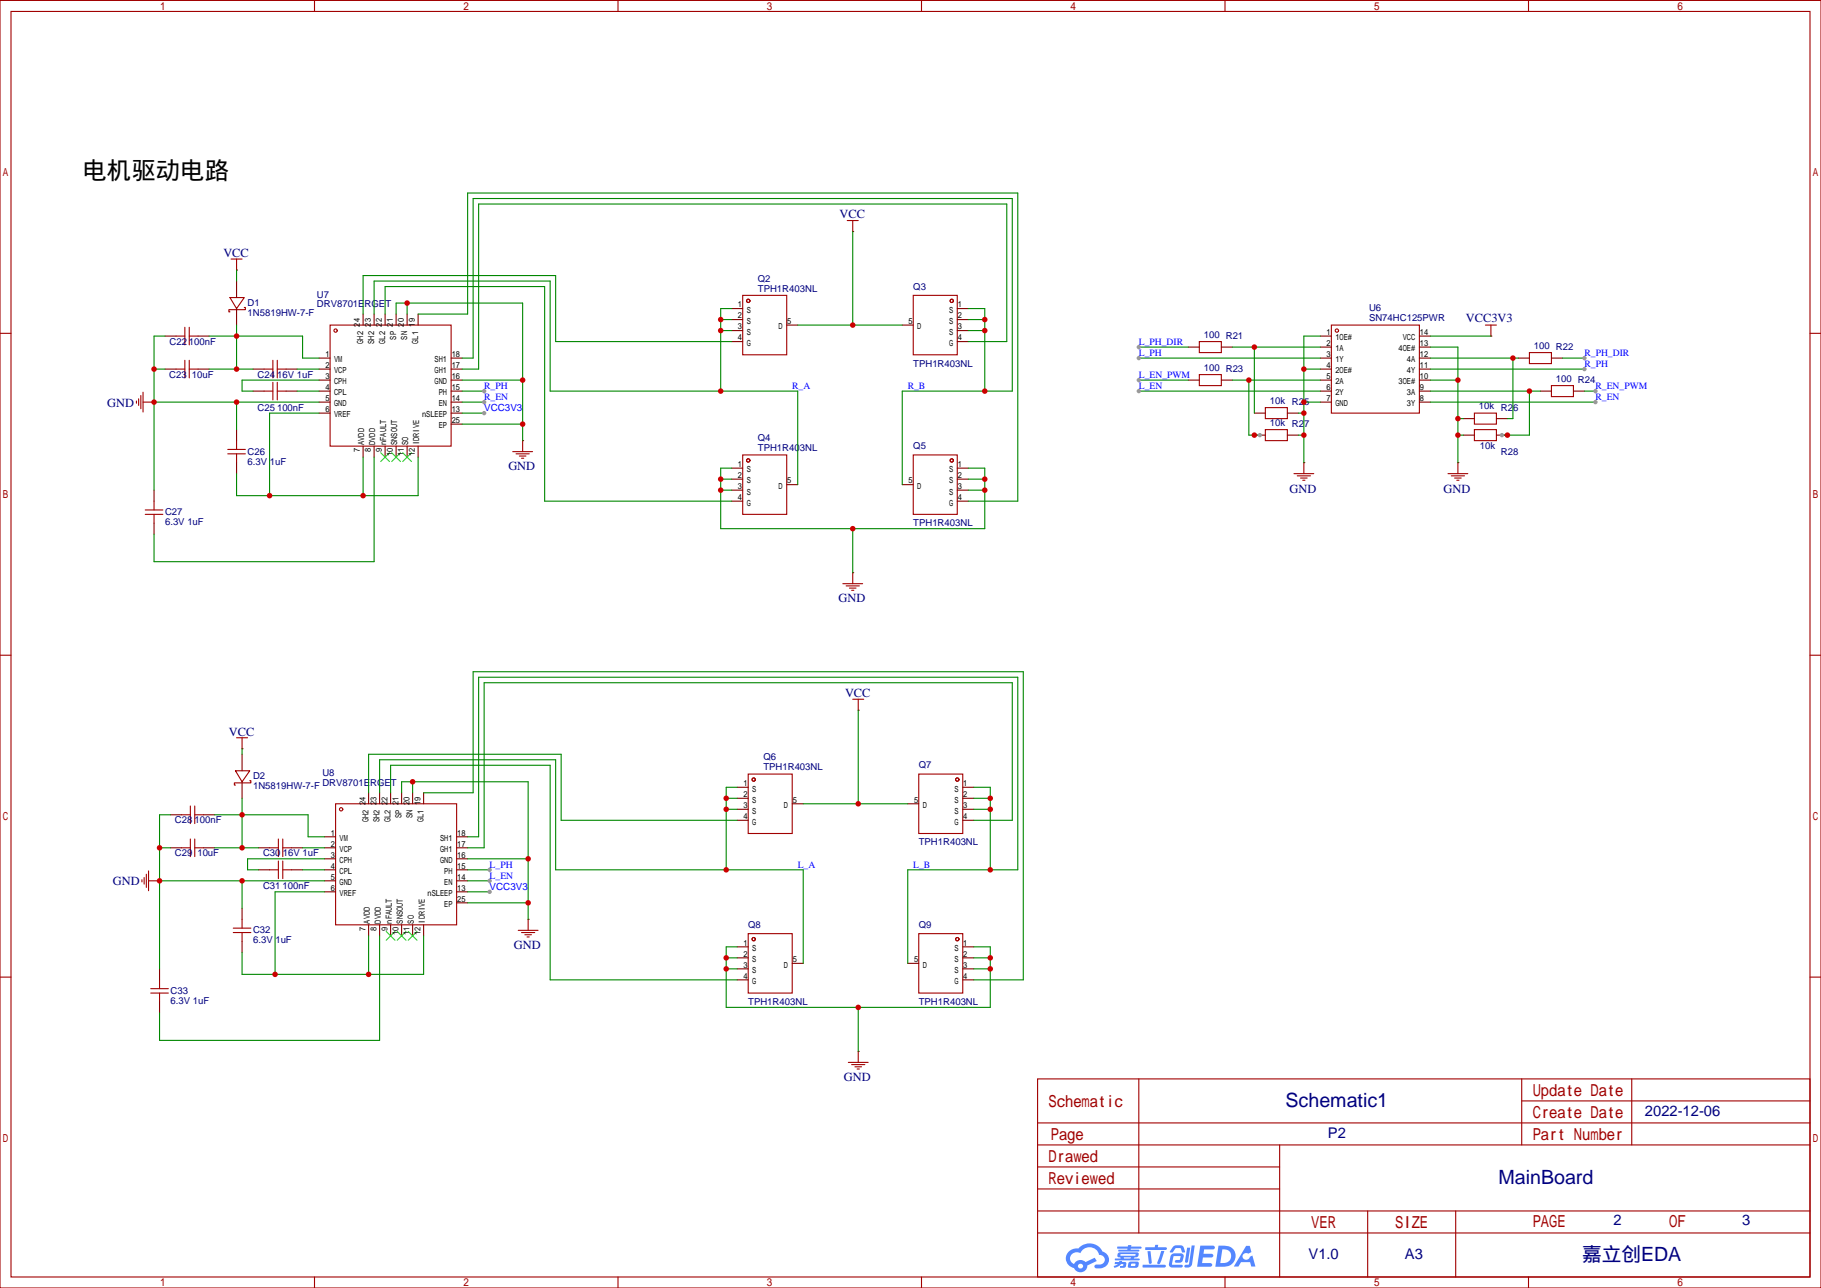
[picture p119: page 2]

# AD/DA

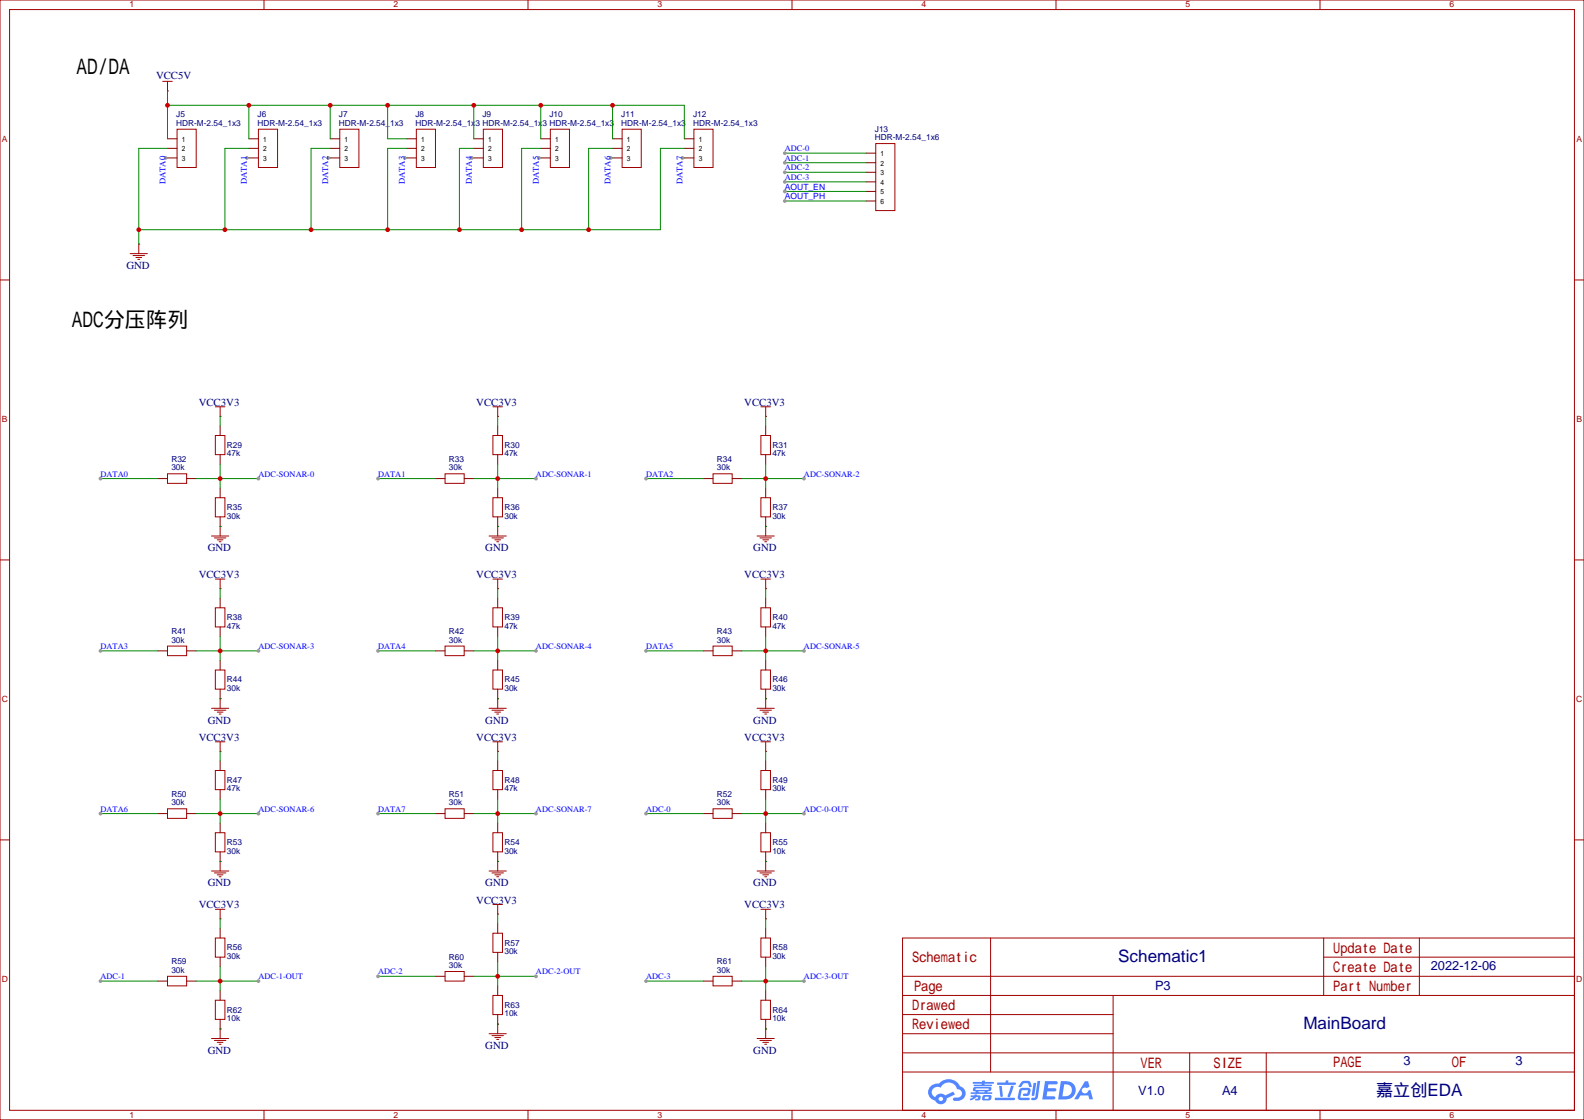
[picture p120: page 3]
