Aimmecat/IEECS-Design/(list of files, drawings)

Other design files:
Hardware/Reference/CHV307核心板资料/【封装】核心板整体原理图+PCB封装/CH32V307VxT6_CoreBoard.PcbLib
Hardware/Reference/CHV307核心板资料/【封装】核心板整体原理图+PCB封装/CH32V307VxT6_CoreBoard.SchLib
