Aimmecat/IEECS-Design/Software/IEECS_Master_ch32v307/project/user/src/isr.c

/*********************************************************************************************************************
* COPYRIGHT NOTICE
* Copyright (c) 2019,逐飞科技
* All rights reserved.
*
* 以下所有内容版权均属逐飞科技所有，未经允许不得用于商业用途，
* 欢迎各位使用并传播本程序，修改内容时必须保留逐飞科技的版权声明。
*
* @file             isr
* @company          成都逐飞科技有限公司
* @author           逐飞科技(QQ790875685)
* @version          查看doc内version文件 版本说明
* @Software         MounRiver Studio V1.51
* @Target core      CH32V307VCT6
* @Taobao           https://seekfree.taobao.com/
* @date             2021-11-25
*                   V1.1 2022.01.11  对调ch1和ch2的蓝牙回调函数位置
********************************************************************************************************************/

#include "headfile.h"
void NMI_Handler(void)       __attribute__((interrupt("WCH-Interrupt-fast")));
void HardFault_Handler(void) __attribute__((interrupt("WCH-Interrupt-fast")));

void USART1_IRQHandler(void) __attribute__((interrupt("WCH-Interrupt-fast")));
//void USART2_IRQHandler(void) __attribute__((interrupt("WCH-Interrupt-fast")));
void USART3_IRQHandler(void) __attribute__((interrupt("WCH-Interrupt-fast")));
void UART4_IRQHandler (void) __attribute__((interrupt("WCH-Interrupt-fast")));
void UART5_IRQHandler (void) __attribute__((interrupt("WCH-Interrupt-fast")));
void UART6_IRQHandler (void) __attribute__((interrupt("WCH-Interrupt-fast")));
void UART7_IRQHandler (void) __attribute__((interrupt("WCH-Interrupt-fast")));
void UART8_IRQHandler (void) __attribute__((interrupt("WCH-Interrupt-fast")));
void DVP_IRQHandler (void) __attribute__((interrupt("WCH-Interrupt-fast")));
//void TIM1_BRK_IRQHandler        (void)  __attribute__((interrupt("WCH-Interrupt-fast")));
void TIM1_UP_IRQHandler         (void)  __attribute__((interrupt("WCH-Interrupt-fast")));
//void TIM1_TRG_COM_IRQHandler    (void)  __attribute__((interrupt("WCH-Interrupt-fast")));
//void TIM1_CC_IRQHandler         (void)  __attribute__((interrupt("WCH-Interrupt-fast")));
void TIM2_IRQHandler            (void)  __attribute__((interrupt("WCH-Interrupt-fast")));
void TIM3_IRQHandler            (void)  __attribute__((interrupt("WCH-Interrupt-fast")));
void TIM4_IRQHandler            (void)  __attribute__((interrupt("WCH-Interrupt-fast")));
void TIM5_IRQHandler            (void)  __attribute__((interrupt("WCH-Interrupt-fast")));
void TIM6_IRQHandler            (void)  __attribute__((interrupt("WCH-Interrupt-fast")));
void TIM7_IRQHandler            (void)  __attribute__((interrupt("WCH-Interrupt-fast")));
//void TIM8_BRK_IRQHandler        (void)  __attribute__((interrupt("WCH-Interrupt-fast")));
void TIM8_UP_IRQHandler         (void)  __attribute__((interrupt("WCH-Interrupt-fast")));
//void TIM8_TRG_COM_IRQHandler    (void)  __attribute__((interrupt("WCH-Interrupt-fast")));
//void TIM8_CC_IRQHandler         (void)  __attribute__((interrupt("WCH-Interrupt-fast")));
//void TIM9_BRK_IRQHandler        (void)  __attribute__((interrupt("WCH-Interrupt-fast")));
void TIM9_UP_IRQHandler         (void)  __attribute__((interrupt("WCH-Interrupt-fast")));
//void TIM9_TRG_COM_IRQHandler    (void)  __attribute__((interrupt("WCH-Interrupt-fast")));
//void TIM9_CC_IRQHandler         (void)  __attribute__((interrupt("WCH-Interrupt-fast")));
//void TIM10_BRK_IRQHandler       (void)  __attribute__((interrupt("WCH-Interrupt-fast")));
void TIM10_UP_IRQHandler        (void)  __attribute__((interrupt("WCH-Interrupt-fast")));
//void TIM10_TRG_COM_IRQHandler   (void)  __attribute__((interrupt("WCH-Interrupt-fast")));
//void TIM10_CC_IRQHandler        (void)  __attribute__((interrupt("WCH-Interrupt-fast")));

void EXTI0_IRQHandler(void) __attribute__((interrupt("WCH-Interrupt-fast")));
void EXTI1_IRQHandler(void) __attribute__((interrupt("WCH-Interrupt-fast")));
void EXTI2_IRQHandler(void) __attribute__((interrupt("WCH-Interrupt-fast")));
void EXTI3_IRQHandler(void) __attribute__((interrupt("WCH-Interrupt-fast")));
void EXTI4_IRQHandler(void) __attribute__((interrupt("WCH-Interrupt-fast")));
void EXTI9_5_IRQHandler(void) __attribute__((interrupt("WCH-Interrupt-fast")));
void EXTI15_10_IRQHandler(void) __attribute__((interrupt("WCH-Interrupt-fast")));

void USART1_IRQHandler(void)
{
    if(USART_GetITStatus(USART1, USART_IT_RXNE) != RESET)
    {

        USART_ClearITPendingBit(USART1, USART_IT_RXNE);
    }
}
//void USART2_IRQHandler(void)
//{
//    if(USART_GetITStatus(USART2, USART_IT_RXNE) != RESET)
//    {
//        if(wireless_type == WIRELESS_UART)
//        {
//            wireless_uart_callback();
//        }
//        else if(wireless_type == BLUETOOTH_CH9141)
//        {
//            bluetooth_ch9141_uart_callback_ch2();
//        }
//        else if(wireless_type == WIRELESS_CH573)
//        {
//            wireless_ch573_callback();
//        }
//        USART_ClearITPendingBit(USART2, USART_IT_RXNE);
//    }
//}
void USART3_IRQHandler(void)
{
    if(USART_GetITStatus(USART3, USART_IT_RXNE) != RESET)
    {

        USART_ClearITPendingBit(USART3, USART_IT_RXNE);
    }
}
void UART4_IRQHandler (void)
{
    if(USART_GetITStatus(UART4, USART_IT_RXNE) != RESET)
    {

        USART_ClearITPendingBit(UART4, USART_IT_RXNE);
    }
}
void UART5_IRQHandler (void)
{
    if(USART_GetITStatus(UART5, USART_IT_RXNE) != RESET)
    {
        camera_uart_handler();
        USART_ClearITPendingBit(UART5, USART_IT_RXNE);
    }
}
void UART6_IRQHandler (void)
{
    if(USART_GetITStatus(UART6, USART_IT_RXNE) != RESET)
    {

        USART_ClearITPendingBit(UART6, USART_IT_RXNE);
    }
}
void UART7_IRQHandler (void)
{
    if(USART_GetITStatus(UART7, USART_IT_RXNE) != RESET)
    {
        if(wireless_type == WIRELESS_UART)
        {

        }
        else if(wireless_type == BLUETOOTH_CH9141)
        {
            bluetooth_ch9141_uart_callback_ch1();
        }
        USART_ClearITPendingBit(UART7, USART_IT_RXNE);
    }
}
void UART8_IRQHandler (void)
{
    if(USART_GetITStatus(UART8, USART_IT_RXNE) != RESET)
    {
//        extern void uart_handler (void);
//        uart_handler();
        USART_ClearITPendingBit(UART8, USART_IT_RXNE);
    }
}



void DVP_IRQHandler(void)
{
    if (DVP->IFR & RB_DVP_IF_FRM_DONE)
    {
        camera_dvp_handler();
        DVP->IFR &= ~RB_DVP_IF_FRM_DONE;
    }
}
void EXTI0_IRQHandler(void)
{
    if(SET == EXTI_GetITStatus(EXTI_Line0))
    {
        EXTI_ClearITPendingBit(EXTI_Line0);
    }
}

void EXTI1_IRQHandler(void)
{
    if(SET == EXTI_GetITStatus(EXTI_Line1))
    {
        EXTI_ClearITPendingBit(EXTI_Line1);

    }
}

void EXTI2_IRQHandler(void)
{
    if(SET == EXTI_GetITStatus(EXTI_Line2))
    {
        EXTI_ClearITPendingBit(EXTI_Line2);

    }
}

void EXTI3_IRQHandler(void)
{
    if(SET == EXTI_GetITStatus(EXTI_Line3))
    {
        EXTI_ClearITPendingBit(EXTI_Line3);

    }
}

void EXTI4_IRQHandler(void)
{
    if(SET == EXTI_GetITStatus(EXTI_Line4))
    {
        EXTI_ClearITPendingBit(EXTI_Line4);

    }
}
void EXTI9_5_IRQHandler(void)
{
    if(SET == EXTI_GetITStatus(EXTI_Line5))
    {
        EXTI_ClearITPendingBit(EXTI_Line5);

    }
    if(SET == EXTI_GetITStatus(EXTI_Line6))
    {
        EXTI_ClearITPendingBit(EXTI_Line6);

    }
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
//   .weak   TIM2_IRQHandler            /* TIM2 */
//   .weak   TIM3_IRQHandler            /* TIM3 */
//   .weak   TIM4_IRQHandler            /* TIM4 */
//   .weak   I2C1_EV_IRQHandler         /* I2C1 Event */
//   .weak   I2C1_ER_IRQHandler         /* I2C1 Error */
//   .weak   I2C2_EV_IRQHandler         /* I2C2 Event */
//   .weak   I2C2_ER_IRQHandler         /* I2C2 Error */
//   .weak   SPI1_IRQHandler            /* SPI1 */
//   .weak   SPI2_IRQHandler            /* SPI2 */
//   .weak   USART1_IRQHandler          /* USART1 */
//   .weak   USART2_IRQHandler          /* USART2 */
//   .weak   USART3_IRQHandler          /* USART3 */
//   .weak   EXTI15_10_IRQHandler       /* EXTI Line 15..10 */
//   .weak   RTCAlarm_IRQHandler        /* RTC Alarm through EXTI Line */
//   .weak   USBWakeUp_IRQHandler       /* USB Wakeup from suspend */
//   .weak   TIM8_BRK_IRQHandler        /* TIM8 Break */
//   .weak   TIM8_UP_IRQHandler         /* TIM8 Update */
//   .weak   TIM8_TRG_COM_IRQHandler    /* TIM8 Trigger and Commutation */
//   .weak   TIM8_CC_IRQHandler         /* TIM8 Capture Compare */
//   .weak   RNG_IRQHandler             /* RNG */
//   .weak   FSMC_IRQHandler            /* FSMC */
//   .weak   SDIO_IRQHandler            /* SDIO */
//   .weak   TIM5_IRQHandler            /* TIM5 */
//   .weak   SPI3_IRQHandler            /* SPI3 */
//   .weak   UART4_IRQHandler           /* UART4 */
//   .weak   UART5_IRQHandler           /* UART5 */
//   .weak   TIM6_IRQHandler            /* TIM6 */
//   .weak   TIM7_IRQHandler            /* TIM7 */
//   .weak   DMA2_Channel1_IRQHandler   /* DMA2 Channel 1 */
//   .weak   DMA2_Channel2_IRQHandler   /* DMA2 Channel 2 */
//   .weak   DMA2_Channel3_IRQHandler   /* DMA2 Channel 3 */
//   .weak   DMA2_Channel4_IRQHandler   /* DMA2 Channel 4 */
//   .weak   DMA2_Channel5_IRQHandler   /* DMA2 Channel 5 */
//   .weak   ETH_IRQHandler             /* ETH */
//   .weak   ETH_WKUP_IRQHandler        /* ETH WakeUp */
//   .weak   CAN2_TX_IRQHandler         /* CAN2 TX */
//   .weak   CAN2_RX0_IRQHandler        /* CAN2 RX0 */
//   .weak   CAN2_RX1_IRQHandler        /* CAN2 RX1 */
//   .weak   CAN2_SCE_IRQHandler        /* CAN2 SCE */
//   .weak   OTG_FS_IRQHandler          /* OTGFS */
//   .weak   USBHSWakeup_IRQHandler     /* USBHS Wakeup */
//   .weak   USBHS_IRQHandler           /* USBHS */
//   .weak   DVP_IRQHandler             /* DVP */
//   .weak   UART6_IRQHandler           /* UART6 */
//   .weak   UART7_IRQHandler           /* UART7 */
//   .weak   UART8_IRQHandler           /* UART8 */
//   .weak   TIM9_BRK_IRQHandler        /* TIM9 Break */
//   .weak   TIM9_UP_IRQHandler         /* TIM9 Update */
//   .weak   TIM9_TRG_COM_IRQHandler    /* TIM9 Trigger and Commutation */
//   .weak   TIM9_CC_IRQHandler         /* TIM9 Capture Compare */
//   .weak   TIM10_BRK_IRQHandler       /* TIM10 Break */
//   .weak   TIM10_UP_IRQHandler        /* TIM10 Update */
//   .weak   TIM10_TRG_COM_IRQHandler   /* TIM10 Trigger and Commutation */
//   .weak   TIM10_CC_IRQHandler        /* TIM10 Capture Compare */
//   .weak   DMA2_Channel6_IRQHandler   /* DMA2 Channel 6 */
//   .weak   DMA2_Channel7_IRQHandler   /* DMA2 Channel 7 */
//   .weak   DMA2_Channel8_IRQHandler   /* DMA2 Channel 8 */
//   .weak   DMA2_Channel9_IRQHandler   /* DMA2 Channel 9 */
//   .weak   DMA2_Channel10_IRQHandler  /* DMA2 Channel 10 */
//   .weak   DMA2_Channel11_IRQHandler  /* DMA2 Channel 11 */

/*******************************************************************************
* Function Name  : NMI_Handler
* Description    : This function handles NMI exception.
* Input          : None
* Return         : None
*******************************************************************************/
void NMI_Handler(void)
{
}

/*******************************************************************************
* Function Name  : HardFault_Handler
* Description    : This function handles Hard Fault exception.
* Input          : None
* Return         : None
*******************************************************************************/
void HardFault_Handler(void)
{
  while (1)
  {
  }
}
