Aimmecat/IEECS-Design/Software/IEECS_Master_ch32v307/project/code/Dac.c

/*
 * Dac.c
 *
 *  Created on: Nov 13, 2022
 *      Author: Aimmecat
 */

#include "headfile.h"

//PWM模拟Dac输出

void Dac_Init(void){
    pwm_init(DAC_OUTPUT1,17000,0);
    pwm_init(DAC_OUTPUT1,17000,0);
}

void Dac_Output(void){
    pwm_set_duty(DAC_OUTPUT1, (uint32)(voltage * KP_VOLTAGE));
    pwm_set_duty(DAC_OUTPUT2, (uint32)(voltage * KP_VOLTAGE));
}
