Aimmecat/IEECS-Design/Software/IEECS_Master_ch32v307/project/code/headfile.h

/*
 * headfile.h
 *
 *  Created on: Nov 10, 2022
 *      Author: Aimmecat
 */

#ifndef HEADFILE_H_
#define HEADFILE_H_

#include "math.h"
#include "stdbool.h"
#include "zf_common_headfile.h"

#include <Key.h>
#include "Util.h"
#include "Data.h"
#include "Adc.h"
#include "Dac.h"
#include "Robot_Communite.h"
#include "Beep.h"
#include "PID.h"
#include "Motor.h"
#include "Encoder.h"
#include "Menu.h"
#include "Style.h"

#endif /* HEADFILE_H_ */
