Aimmecat/IEECS-Design/Hardware/Reference/CHV307_Library-master/Example/4-Encoder Demo/user/src/main.c

/*********************************************************************************************************************
* COPYRIGHT NOTICE
* Copyright (c) 2019,逐飞科技
* All rights reserved.
*
* 以下所有内容版权均属逐飞科技所有，未经允许不得用于商业用途，
* 欢迎各位使用并传播本程序，修改内容时必须保留逐飞科技的版权声明。
*
* @file             main
* @company          成都逐飞科技有限公司
* @author          逐飞科技(QQ790875685)
* @version          查看doc内version文件 版本说明
* @Software         MounRiver Studio V1.51
* @Target core      CH32V307VCT6
* @Taobao           https://seekfree.taobao.com/
* @date             2021-11-25
********************************************************************************************************************/


// *************************** 例程硬件连接说明 ***************************
// 使用逐飞科技 WCH-LINK 调试下载器连接
//      直接将下载器正确连接在核心板的调试下载接口即可
// 使用 USB-TTL 模块连接
//      模块管脚            单片机管脚
//      USB-TTL-RX          查看 zf_common_debug.h 文件中 DEBUG_UART_TX_PIN 宏定义的引脚 默认 A9
//      USB-TTL-TX          查看 zf_common_debug.h 文件中 DEBUG_UART_RX_PIN 宏定义的引脚 默认 A10
//      USB-TTL-GND         核心板电源地 GND
//      USB-TTL-3V3         核心板 3V3 电源
// 接入正交编码器连接
//      模块管脚            单片机管脚
//      A                   ENCODER_QUADDEC_A 宏定义的引脚 默认 B4
//      B                   ENCODER_QUADDEC_B 宏定义的引脚 默认 B5
//      GND                 核心板电源地 GND
//      3V3                 核心板 3V3 电源
// 接入方向编码器连接
//      模块管脚            单片机管脚
//      LSB                 ENCODER_DIR_PULSE 宏定义的引脚 默认 B6
//      DIR                 ENCODER_DIR_DIR 宏定义的引脚 默认 B7
//      GND                 核心板电源地 GND
//      3V3                 核心板 3V3 电源

// *************************** 例程测试说明 ***************************
// 1.核心板烧录完成本例程，单独使用核心板与调试下载器或者 USB-TTL 模块，并连接好编码器，在断电情况下完成连接
// 2.将调试下载器或者 USB-TTL 模块连接电脑，完成上电
// 3.电脑上使用串口助手打开对应的串口，串口波特率为 zf_common_debug.h 文件中 DEBUG_UART_BAUDRATE 宏定义 默认 115200，核心板按下复位按键
// 4.可以在串口助手上看到如下串口信息：
//      ENCODER_QUADDEC counter     x .
//      ENCODER_DIR counter         x .
// 5.转动编码器就会看到数值变化
// 如果发现现象与说明严重不符 请参照本文件最下方 例程常见问题说明 进行排查


// **************************** 代码区域 ****************************
#define ENCODER_QUADDEC                 TIM9_ENCOEDER
#define ENCODER_QUADDEC_B               TIM9_CH2_ENCOEDER_D11
#define ENCODER_QUADDEC_A               TIM9_CH1_ENCOEDER_D9

#define ENCODER_DIR                     TIM1_ENCOEDER
#define ENCODER_DIR_PULSE               TIM1_CH2_ENCOEDER_E11
#define ENCODER_DIR_DIR                 TIM1_CH1_ENCOEDER_E9

#include "zf_common_headfile.h"

int16 encoder_data = 0;

int main(void)
{
    interrupt_global_disable();             // 关闭总中断
    clock_init(SYSTEM_CLOCK_144M);          // 务必保留，设置系统时钟。
    debug_init();                           // 务必保留，本函数用于初始化MPU 时钟 调试串口

    // 定时器编码器模式采集初始化
	// 使用定时器1，E9 和 E11作为输入引脚
    encoder_init_dir(ENCODER_DIR, ENCODER_DIR_DIR, ENCODER_DIR_PULSE);          // 初始化编码器模块与引脚 带方向增量编码器模式
    encoder_init_quad(ENCODER_QUADDEC, ENCODER_QUADDEC_A, ENCODER_QUADDEC_B);   // 初始化编码器模块与引脚 正交解码编码器模式


    interrupt_global_enable();            // 总中断最后开启
    while(1)
    {
        encoder_data = encoder_get_count(ENCODER_QUADDEC);                      // 获取编码器计数
        encoder_clear_count(ENCODER_QUADDEC);                                   // 清空编码器计数
        printf("ENCODER_QUADDEC counter \t%d .\r\n", encoder_data);             // 输出编码器计数信息

//        encoder_data = encoder_get_count(ENCODER_DIR);                          // 获取编码器计数
//        encoder_clear_count(ENCODER_DIR);                                       // 清空编码器计数
//        printf("ENCODER_DIR counter \t\t%d .\r\n", encoder_data);               // 输出编码器计数信息

        system_delay_ms(100);
    }
}
// **************************** 代码区域 ****************************


// *************************** 例程常见问题说明 ***************************
// 遇到问题时请按照以下问题检查列表检查
// 问题1：串口没有数据
//      查看串口助手打开的是否是正确的串口，检查打开的 COM 口是否对应的是调试下载器或者 USB-TTL 模块的 COM 口
//      如果是使用逐飞科技 WCH-LINK 调试下载器连接，那么检查下载器线是否松动，检查核心板串口跳线是否已经焊接，串口跳线查看核心板原理图即可找到
//      如果是使用 USB-TTL 模块连接，那么检查连线是否正常是否松动，模块 TX 是否连接的核心板的 RX，模块 RX 是否连接的核心板的 TX
// 问题2：串口数据乱码
//      查看串口助手设置的波特率是否与程序设置一致，程序中 zf_common_debug.h 文件中 DEBUG_UART_BAUDRATE 宏定义为 debug uart 使用的串口波特率
// 问题3：数值一直在正负一跳转
//      不要把方向编码器接在正交编码器模式的接口下
// 问题4：数值不随编码转动变化
//      如果使用主板测试，主板必须要用电池供电
//      检查编码器是否是正常的，线是否松动，编码器是否发热烧了，是否接错线
