Aimmecat/IEECS-Design/Hardware/Reference/CHV307_Library-master/Example/5-UART Demo/user/src/main.c

/*********************************************************************************************************************
* COPYRIGHT NOTICE
* Copyright (c) 2019,逐飞科技
* All rights reserved.
*
* 以下所有内容版权均属逐飞科技所有，未经允许不得用于商业用途，
* 欢迎各位使用并传播本程序，修改内容时必须保留逐飞科技的版权声明。
*
* @file             main
* @company          成都逐飞科技有限公司
 * @author          逐飞科技(QQ790875685)
* @version          查看doc内version文件 版本说明
* @Software         MounRiver Studio V1.51
* @Target core      CH32V307VCT6
* @Taobao           https://seekfree.taobao.com/
* @date             2021-11-25
********************************************************************************************************************/

// *************************** 例程硬件连接说明 ***************************
// 使用逐飞科技 WCH-LINK 调试下载器连接
//      直接将下载器正确连接在核心板的调试下载接口即可
// 使用 USB-TTL 模块连接
//      模块管脚            单片机管脚
//      USB-TTL-RX          查看 zf_common_debug.h 文件中 DEBUG_UART_TX_PIN 宏定义的引脚 默认 B10
//      USB-TTL-TX          查看 zf_common_debug.h 文件中 DEBUG_UART_RX_PIN 宏定义的引脚 默认 B11
//      USB-TTL-GND         核心板电源地 GND
//      USB-TTL-3V3         核心板 3V3 电源


// *************************** 例程测试说明 ***************************
// 1.核心板烧录完成本例程，单独使用核心板与调试下载器或者 USB-TTL 模块，在断电情况下完成连接
// 2.将调试下载器或者 USB-TTL 模块连接电脑，完成上电
// 3.电脑上使用串口助手打开对应的串口，串口波特率为 DEBUG_UART_BAUDRATE 宏定义 默认 115200，核心板按下复位按键
// 4.可以在串口助手上看到如下串口信息：
//      UART Text.
// 5.通过串口助手发送数据，会收到相同的反馈数据
//      UART get data:.......
// 如果发现现象与说明严重不符 请参照本文件最下方 例程常见问题说明 进行排查


#include "zf_common_headfile.h"

#define UART_INDEX              DEBUG_UART_INDEX                                // 默认 UART_1
#define UART_BAUDRATE           DEBUG_UART_BAUDRATE                             // 默认 115200
#define UART_TX_PIN             DEBUG_UART_TX_PIN                               // 默认 UART3_TX_B10
#define UART_RX_PIN             DEBUG_UART_RX_PIN                               // 默认 UART3_RX_B11

#define UART_PRIORITY           USART1_IRQn                                      // 对应串口中断的中断编号 在 mm32f3277gx.h 头文件中查看 IRQn_Type 枚举体

uint8 uart_get_data[64];                                                        // 串口接收数据缓冲区
uint8 fifo_get_data[64];                                                        // fifo 输出读出缓冲区

uint8 get_data = 0;                                                             // 接收数据变量
uint32 fifo_data_count = 0;                                                     // fifo 数据个数

fifo_struct uart_data_fifo;

int16_t encoder_data;
int main(void)
{
    interrupt_global_disable();            // 关闭总中断
    clock_init(SYSTEM_CLOCK_144M);      // 务必保留，设置系统时钟。
    debug_init();                       // 务必保留，本函数用于初始化MPU 时钟 调试串口

    fifo_init(&uart_data_fifo, uart_get_data, 64);                              // 初始化 fifo 挂载缓冲区

    uart_init(UART_INDEX, UART_BAUDRATE, UART_TX_PIN, UART_RX_PIN);             // 初始化编码器模块与引脚 正交解码编码器模式
    uart_rx_interrupt(UART_INDEX, ENABLE);                                      // 开启 UART_INDEX 的接收中断
    interrupt_set_priority(UART_PRIORITY, 0);                                   // 设置对应 UART_INDEX 的中断优先级为 0

    uart_write_string(UART_INDEX, (const uint8 *)"UART Text.");                 // 输出测试信息
    uart_write_byte(UART_INDEX, '\r');                                          // 输出回车
    uart_write_byte(UART_INDEX, '\n');                                          // 输出换行

    interrupt_global_enable();            // 总中断最后开启
    while(1)
    {
        // 此处编写需要循环执行的代码
        fifo_data_count = fifo_used(&uart_data_fifo);                           // 查看 fifo 是否有数据
        if(fifo_data_count != 0)                                                // 读取到数据了
        {
            fifo_read_buffer(&uart_data_fifo, fifo_get_data, &fifo_data_count, FIFO_READ_AND_CLEAN);    // 将 fifo 中数据读出并清空 fifo 挂载的缓冲
            uart_write_string(UART_INDEX, (const uint8 *)"\r\nUART get data:");                // 输出测试信息
            uart_write_buffer(UART_INDEX, fifo_get_data, fifo_data_count);      // 将读取到的数据发送出去
        }
        system_delay_ms(10);

    }
}
//-------------------------------------------------------------------------------------------------------------------
// @brief       UART_INDEX 的接收中断处理函数 这个函数将在 UART_INDEX 对应的中断调用 详见 isr.c
// @param       void
// @return      void
// Sample usage:                uart_rx_interrupt_handler();
//-------------------------------------------------------------------------------------------------------------------
void uart_rx_interrupt_handler (void)
{
//    get_data = uart_read_byte(UART_INDEX);                                      // 接收数据 while 等待式 不建议在中断使用
    uart_query_byte(UART_INDEX, &get_data);                                     // 接收数据 查询式 有数据会返回 TRUE 没有数据会返回 FALSE
    fifo_write_buffer(&uart_data_fifo, &get_data, 1);                           // 将数据写入 fifo 中
}
// **************************** 代码区域 ****************************

// *************************** 例程常见问题说明 ***************************
// 遇到问题时请按照以下问题检查列表检查
// 问题1：串口没有数据
//      查看串口助手打开的是否是正确的串口，检查打开的 COM 口是否对应的是调试下载器或者 USB-TTL 模块的 COM 口
//      如果是使用逐飞科技 WCH-LINK 调试下载器连接，那么检查下载器线是否松动，检查核心板串口跳线是否已经焊接，串口跳线查看核心板原理图即可找到
//      如果是使用 USB-TTL 模块连接，那么检查连线是否正常是否松动，模块 TX 是否连接的核心板的 RX，模块 RX 是否连接的核心板的 TX
// 问题2：串口数据乱码
//      查看串口助手设置的波特率是否与程序设置一致，程序中 zf_common_debug.h 文件中 DEBUG_UART_BAUDRATE 宏定义为 debug uart 使用的串口波特率
