Aimmecat/IEECS-Design/Hardware/Reference/CH32V307主板资料/ch32v307vct6_mother_board_example(1.3.1)/9-ICM20602 6-Axis Module Demo/user/src/main.c

/*********************************************************************************************************************
* COPYRIGHT NOTICE
* Copyright (c) 2019,逐飞科技
* All rights reserved.
*
* 以下所有内容版权均属逐飞科技所有，未经允许不得用于商业用途，
* 欢迎各位使用并传播本程序，修改内容时必须保留逐飞科技的版权声明。
*
* @file             main
* @company          成都逐飞科技有限公司
 * @author          逐飞科技(QQ790875685)
* @version          查看doc内version文件 版本说明
* @Software         MounRiver Studio V1.51
* @Target core      CH32V307VCT6
* @Taobao           https://seekfree.taobao.com/
* @date             2021-11-25
********************************************************************************************************************/



#include "zf_common_headfile.h"


int main(void)
{
    interrupt_global_disable();            // 关闭总中断
    clock_init(SYSTEM_CLOCK_144M);      // 务必保留，设置系统时钟。
    debug_init();                       // 务必保留，本函数用于初始化MPU 时钟 调试串口

    icm20602_init();                    // 使用硬件SPI通讯

	//在ICM20602初始化的时候，设置的默认量程为±2000dps 和 ±8g
	//如果需要修改可以参考下面的方式：
	//ICM20602_GYRO_CONFIG寄存器
    //设置为:0x00 陀螺仪量程为:±250 dps     获取到的陀螺仪数据除以131           可以转化为带物理单位的数据，单位为：°/s
    //设置为:0x08 陀螺仪量程为:±500 dps     获取到的陀螺仪数据除以65.5          可以转化为带物理单位的数据，单位为：°/s
    //设置为:0x10 陀螺仪量程为:±1000dps     获取到的陀螺仪数据除以32.8          可以转化为带物理单位的数据，单位为：°/s
    //设置为:0x18 陀螺仪量程为:±2000dps     获取到的陀螺仪数据除以16.4          可以转化为带物理单位的数据，单位为：°/s

    //ICM20602_ACCEL_CONFIG寄存器
    //设置为:0x00 加速度计量程为:±2g          获取到的加速度计数据 除以16384      可以转化为带物理单位的数据，单位：g(m/s^2)
    //设置为:0x08 加速度计量程为:±4g          获取到的加速度计数据 除以8192       可以转化为带物理单位的数据，单位：g(m/s^2)
    //设置为:0x10 加速度计量程为:±8g          获取到的加速度计数据 除以4096       可以转化为带物理单位的数据，单位：g(m/s^2)
    //设置为:0x18 加速度计量程为:±16g         获取到的加速度计数据 除以2048       可以转化为带物理单位的数据，单位：g(m/s^2)
	
    interrupt_global_enable();            // 总中断最后开启
    while(1)
    {
        // 采集数据
        icm20602_get_acc();
        icm20602_get_gyro();

        printf("icm_gyro_x = %d\r\n", icm_gyro_x);
        printf("icm_gyro_y = %d\r\n", icm_gyro_y);
        printf("icm_gyro_z = %d\r\n", icm_gyro_z);

        printf("icm_acc_x = %d\r\n", icm_acc_x);
        printf("icm_acc_y = %d\r\n", icm_acc_y);
        printf("icm_acc_z = %d\r\n", icm_acc_z);

        system_delay_ms(100);
    }
}
