Aimmecat/IEECS-Design/(notices)

Notices in the files:
Hardware/Reference/CHV307_Library-master/Example/9-PWM Demo/user/src/main.c:
Copyright (c) 2019,Öð·É¿Æ¼¼
All rights reserved.
Hardware/Reference/CH32V307主板资料/ch32v307vct6_mother_board_example(1.3.1)/20-Wireless to 573 Module Demo/user/src/main.c:
Copyright (c) 2022,Öð·É¿Æ¼¼
Course/6-01sc-spring-2011/6-01sc-spring-2011/contents/software-and-tools/installing-the-6.01-software-on-gnu-linux/index.htm:
(http://web.mit.edu) (http://odl.mit.edu) (http://www.oeconsortium.org/) (http://creativecommons.org/licenses/by-nc-sa/4.0/)
